Sphaeralcea/TTL_Calculator_4_Banger/2816Pgm.jpg

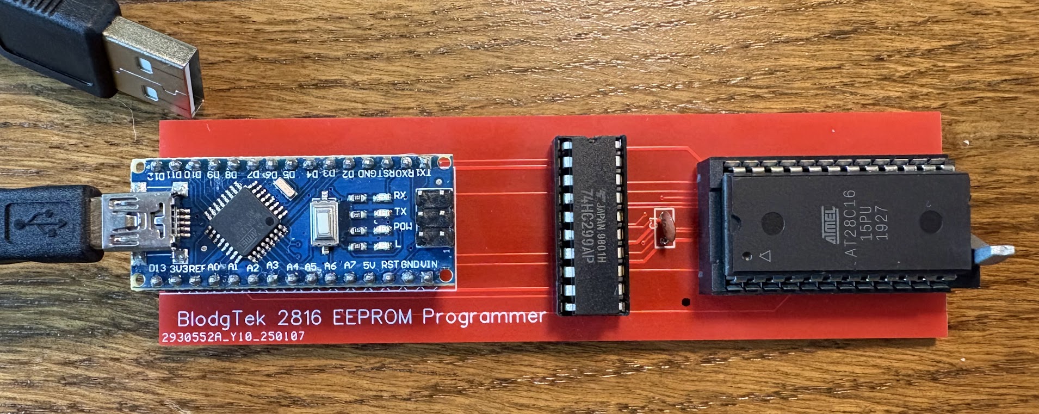
2816Pgm.jpg
