Sphaeralcea/TTL_Calculator_4_Banger/PCB_PIC.jpg

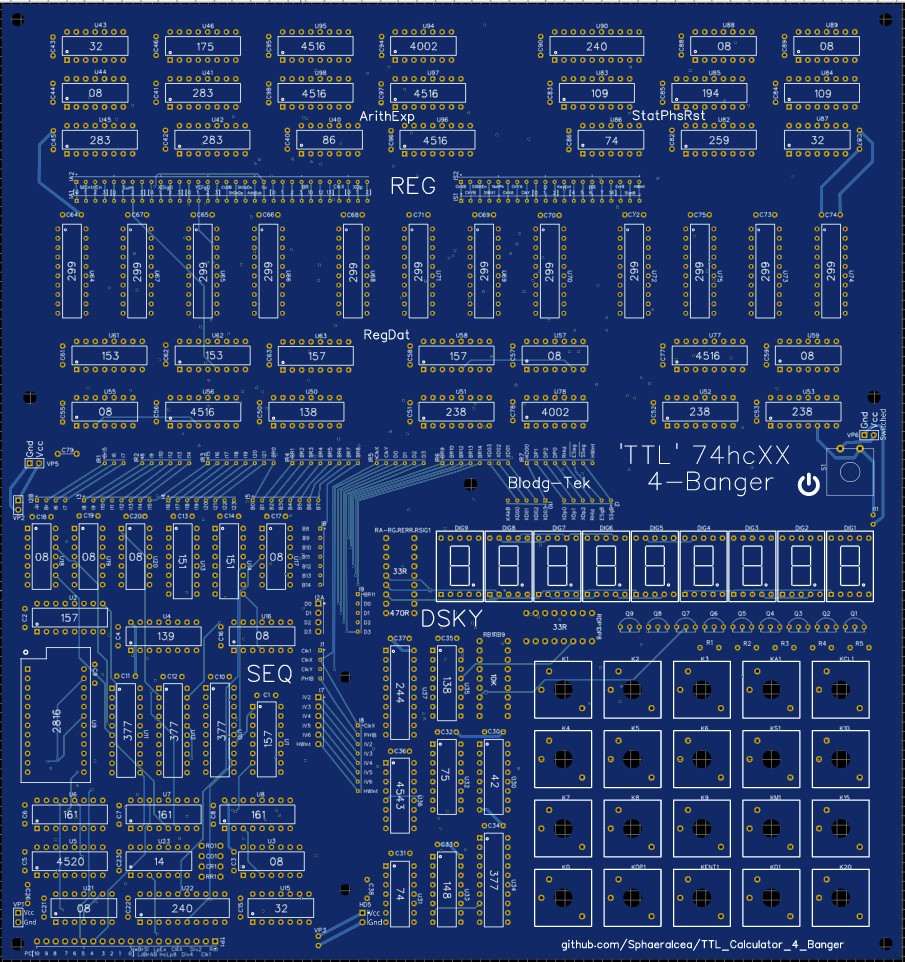
PCB_PIC.jpg
