Sphaeralcea/TTL_Calculator_4_Banger/README.md

# TTL_Calculator_4_Banger
A 4-function, 8-digit, floating point calculator implemented in 74hcXX chips
<pre>
Contents
     Calc4Banger_Overview.pdf - Architecture and design documentation
     BCD_Arithmetic.pdf - Review of BCD addition and subtraction
    *SEQ.pdf - Sequencer unit schematic diagram
    *DSKY.pdf - Display and Keyboard unit schematic diagram
    *REG*.pdf - Register and Arithmatic unit schematic diagram
    uCode7.5.3.2.xlsx - Microcode source
    MathSim2.xlsx - Spreadsheet simulator for math uCode algorithms
    *.h - Microcode object (Arduino C code array)
    *.ini - Arduino based microcode programmer (Arduino C code)
    EEPROM*.pdf - 2816 programmer schematic diagram
    2816Pgm.jpg - Picure of 2816 programmer
    PCB_PIC.jpg - Graphic of the PCB
    4-Banger-Pic.jpg - Picture of the completed project
    CalcRev5.7.3.zip - Zipped Logisim-evolution RTL model
</pre>
