Sphaeralcea/TTL_Calculator_4_Banger/Calc4Banger_Overview.pdf

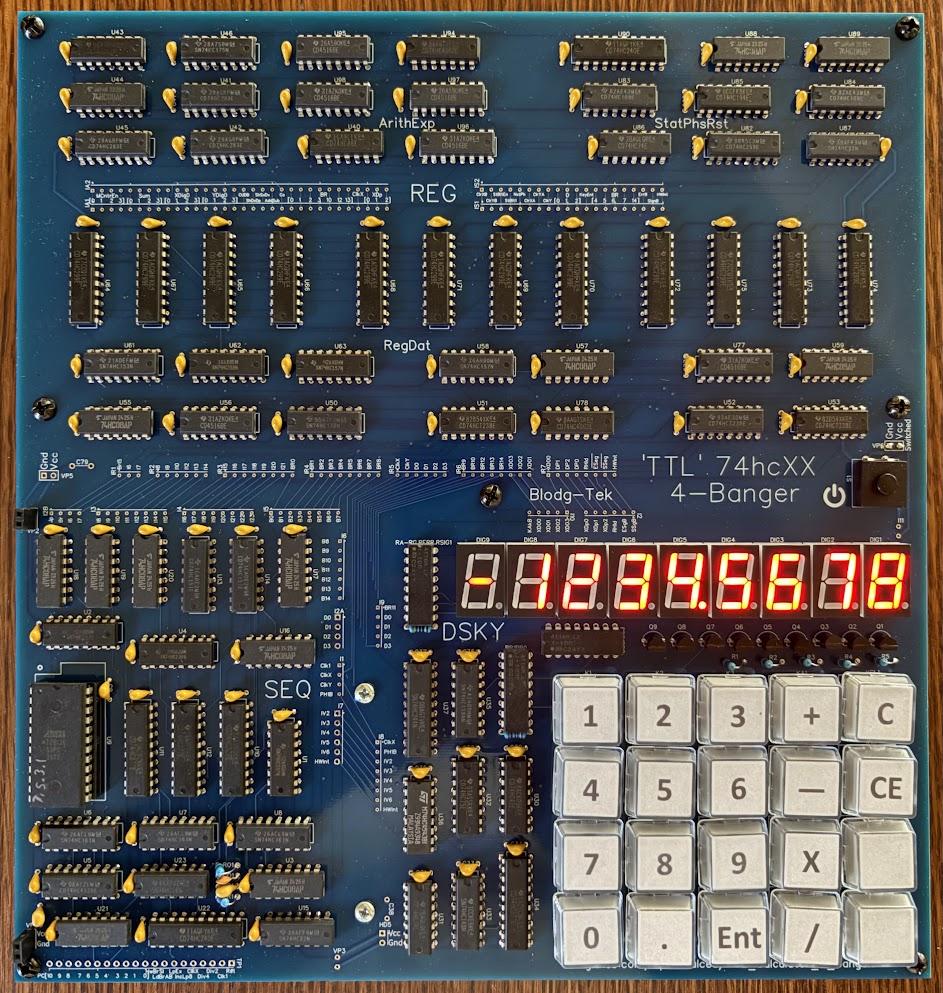
[picture p3: figure]

## https://github.com/Sphaeralcea/TTL_Calculator_4_Banger

# Specs

# - 9x10” PCB, 4 layers - All 74hcXX logic implementation (plus 3 4XXX) chips, 76 total, and one 2816 EEPROM - Purpose built architecture (not a CPU architecture) - RPN style operation (HP Enter key)

- Add, subtract, multiply, and divide, clear entry,

# clear all - 8 numeric digits plus an Error and sign digit - Max num: +99,999,999 to -99,999,999 - Min Num: +0.0000001 to -0.0000001 - Floating decimal point

- Signals error on overflow for all operations,

# divide by 0, and keyboard input overflow - Leading zero blanking during operand entry - Running total operation (last result = Operand1 + Enter) - No rounding logic or guard digits

# A “TTL” 4-Function Calculator Overview

## https://www.youtube.com/watch?v=umok5LHqRb0

# Top Level

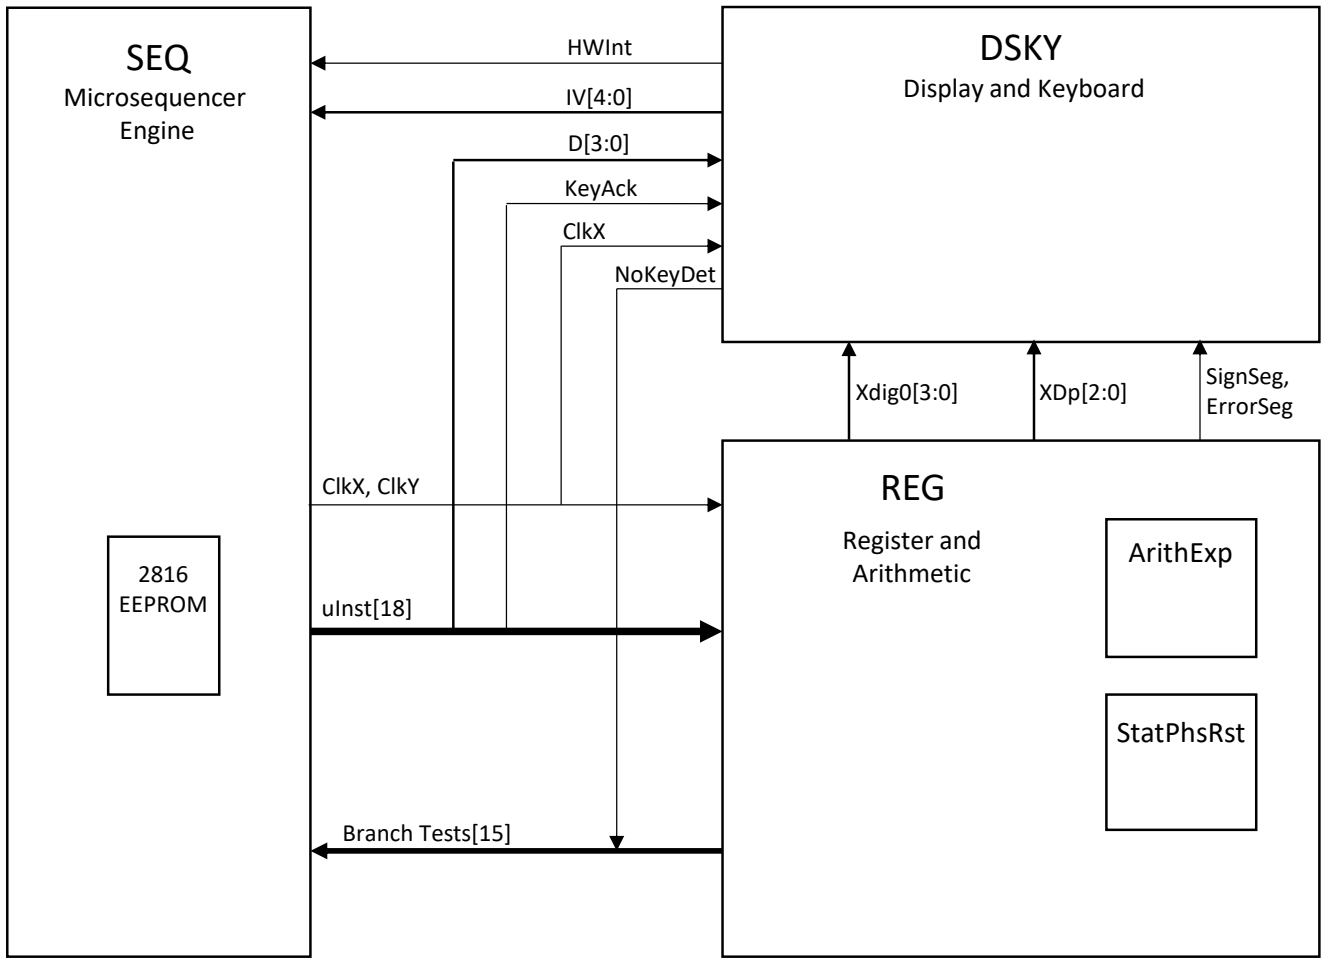
[picture p4: figure]
SEQ; DSKY; REG; ArithExp; StatPhsRst; HWInt; KeyAck; Branch Tests[15]; uInst[18]; ClkX, ClkY; ClkX; NoKeyDet; 2816 EEPROM; Microsequencer Engine; Display and Keyboard; Register and Arithmetic; Xdig0[3:0]; XDp[2:0]; SignSeg,; ErrorSeg

# Overview

# 3 Major logic blocks

# - SEQ: Micro-sequencer engine with 2Kx8b uROM - 24-bit micro-instruction word - Unconditional branch, 16 conditional branches, 1 NMI-type interrupt - Single level loop counter (no nesting) - Clock and reset generation - DSKY: Keyboard and Display unit

- 9-digit LED display sequencing,

# - 18(20)-key keyboard encoding (2 keys not used) - REG: Register-Arithmetic unit - 3, 8-digit registers (4-bits X 8) - 1 digit BCD adder/subtractor and exponent calculator (counters)

- 7 status and control register bits,

# operation progress tracking state machine

# - Architectural deficits (intentional) - No rounding logic, guard digits - Architectural bugs (unintentional) - Accuracy loss dividing 2 8-digit integers

# Top Level Process View

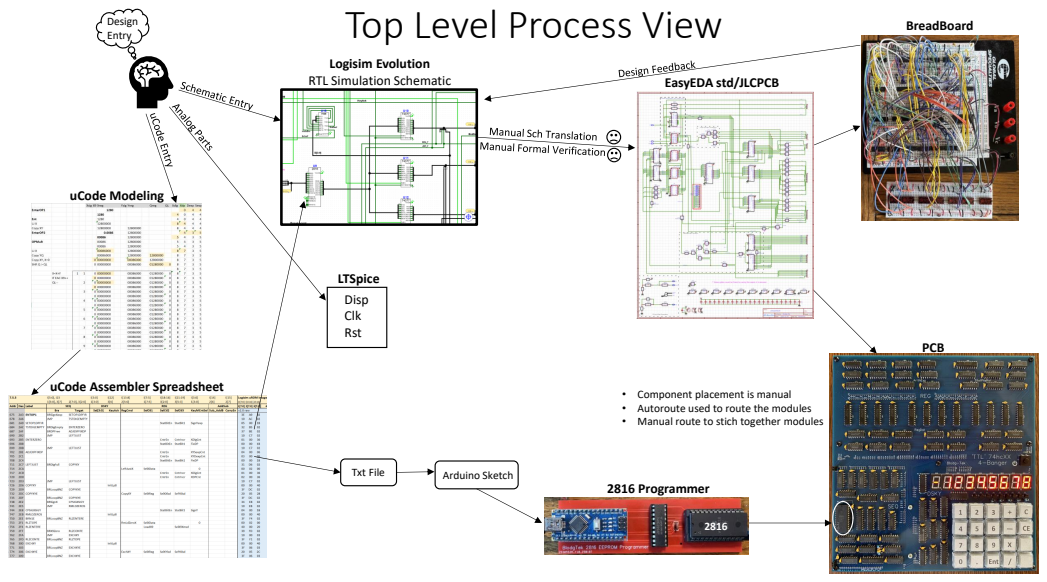
[picture p5: page 4]
Txt File; Arduino Sketch; Design Entry; BreadBoard; Logisim Evolution; RTL Simulation Schematic; EasyEDA std/JLCPCB; PCB; 2816 Programmer; uCode Modeling; Disp Clk Rst; LTSpice

uCode Assembler Spreadsheet

• Component placement is manual
• Autoroute used to route the modules
• Manual route to stich together modules

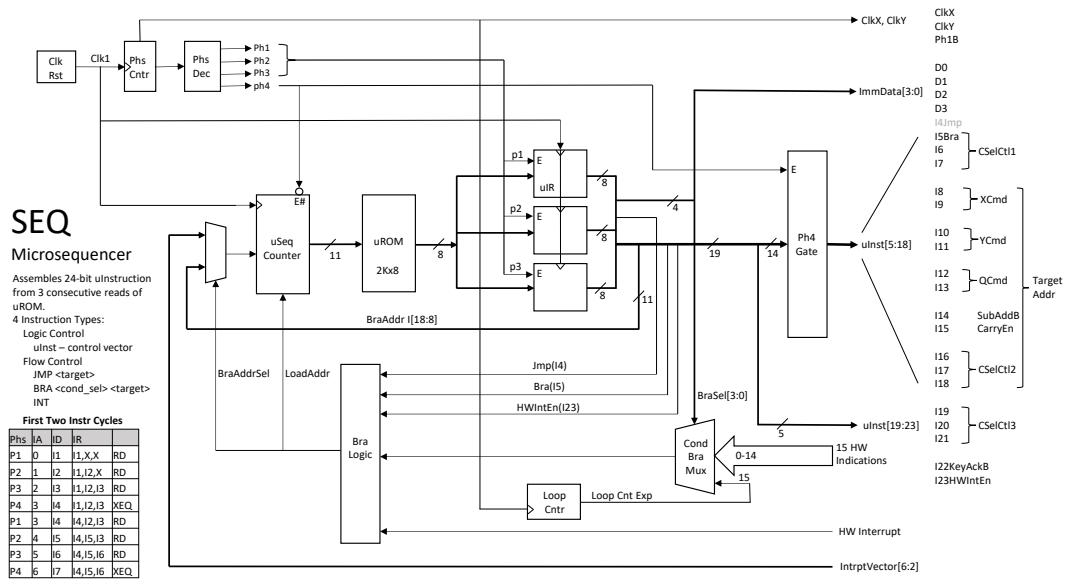
[picture p6: page 5]

Phs | IA | ID | IR
P1 | 0 | I1 | I1,X,X | RD
P2 | 1 | I2 | I1,I2,X | RD
P3 | 2 | I3 | I1,I2,I3 | RD
P4 | 3 | I4 | I1,I2,I3 | XEQ
P1 | 3 | I4 | I4,I2,I3 | RD
P2 | 4 | I5 | I4,I5,I3 | RD
P3 | 5 | I6 | I4,I5,I6 | RD
P4 | 6 | I7 | I4,I5,I6 | XEQ

# Power-On Reset Startup

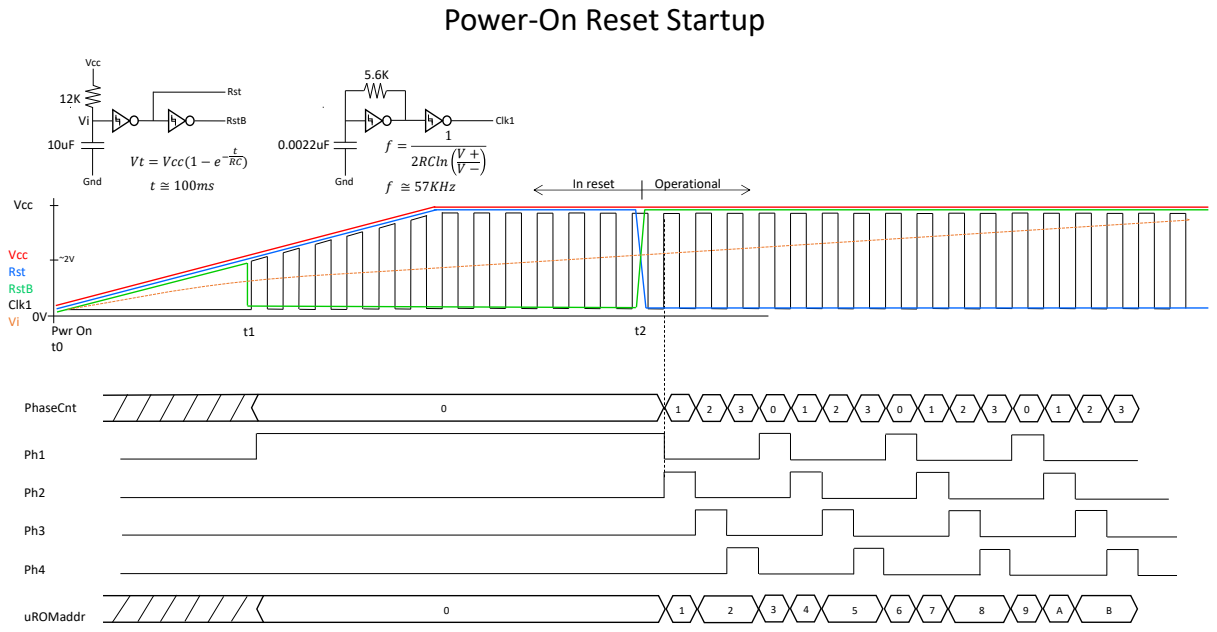
[picture p7: page 6]
PhaseCnt; uROMaddr; Vcc Rst RstB Clk1 Vi; Vcc; In reset; Operational; Pwr On; Gnd; Rst; RstB; Vt = Vcc(1− e; 1 2RCln V + V −; Clk1; f ≅ 57KHz

# Sequencer (SEQ)

# - Includes Clock, Reset and Timing generation

# - Schmitt trigger reset holds sequencer in reset until power rises to ~75% VCC - Schmitt trigger oscillator generates 1X clock - 1X clock drives SEQ logic only. Does not clock other units

- 1X clock feeds the uInst PC, the IR, and the phase counter which also generates the div4

# clocks, ClkX and ClkY - ClkX and ClkY clock the other units

# - Sequencer operates on a 4-phase instruction cycle to construct and present a 24-bit micro-instruction, 23 of which are available to control external hardware

- First 3 phases read three consecutive bytes from uROM and stores them in 3 8-bit registers

# - During first 3 phases, external hardware sees 0’s (inactive) on all signals - Fourth phase ungates the uInstruction and presents it to external hardware - D0 – D3: Immediate data and select field - I4: Instruction type. This bit is reserved for the sequencer’s exclusive use

# - I4=0: Instruction is a hardware control instruction - I4=1: Instruction is a flow control instruction (JMP or BRA)

# Sequencer (SEQ)

# - I5: HW control and flow control qualifier

# - If I4=0, then I5 is just another hardware control bit - If I4=1, then I5 is flow control qualifier

## - I5=0, unconditional (JMP) - I5=1, conditional (BRA)

- One of 16 conditions is tested, selected by D[3:0]. If condition is true then branch is taken

## - D[3:0]=0xF is reserved. Dedicated internally to implement a simple for-loop capability

# - I6 – I21: uINSTR bits

- I22: Loop Init: Used internal to SEQ to reset a counter that implements a simple for-loop

# capability

# - I22 is also used as external to SEQ to register the state of keyboard (KeyAckB)

- I23: Interrupt enable. Used internal to SEQ to enable a hardware-initiated branch. Taken

# if external hardware has asserted the HWInt signal

# - External hardware provides the target address through a 5-bit vector, IV[6:2] - The target address is formed by appending IV[6:2] with b00

- Hardware jump targets are confined to uROM addresses at 4-byte boundaries between 0x10 to 0x7C

# - I23 is available external to SEQ but not used

# Sequencer (SEQ)

# - A primitive looping structure provides the ability to create loops up to 9 iterations (0-8)

# - Loop counter reset by asserting I22 (InitLP8) - Loop count tested and incremented by a conditional jump with D[3:0]=0xF (BRLoop8NZ) - Loop count expires when loop count reaches 8, and loop will fall through on the next loop count test (BRLoop8NZ)

- Note: There is no subroutine call and return capability provided.

# - Since all keyboard service routines return to the keyboard-display loop, an unconditional JMP to this loop serves as an adequate return from keyboard service

routines.

# Sequencer Instruction Timing

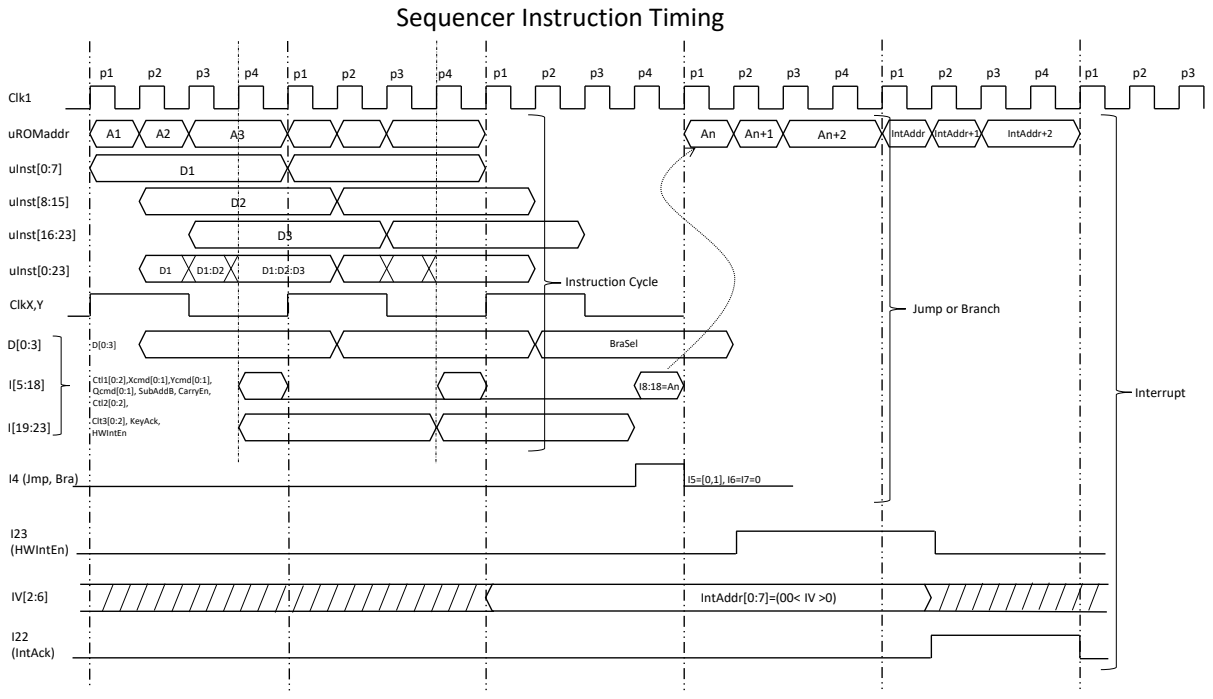
[picture p8: page 10]
uROMaddr; uInst[0:7]; uInst[8:15]; uInst[16:23]; uInst[0:23]; Clt3[0:2], KeyAck, HWIntEn; Ctl1[0:2],Xcmd[0:1],Ycmd[0:1], Qcmd[0:1], SubAddB, CarryEn, Ctl2[0:2],; ClkX,Y; Clk1; I4 (Jmp, Bra); I23 (HWIntEn); IntAddr; IntAddr[0:7]=(00< IV >0); IntAddr+1; IntAddr+2; I22 (IntAck); Interrupt; Instruction Cycle; BraSel

Jump or Branch

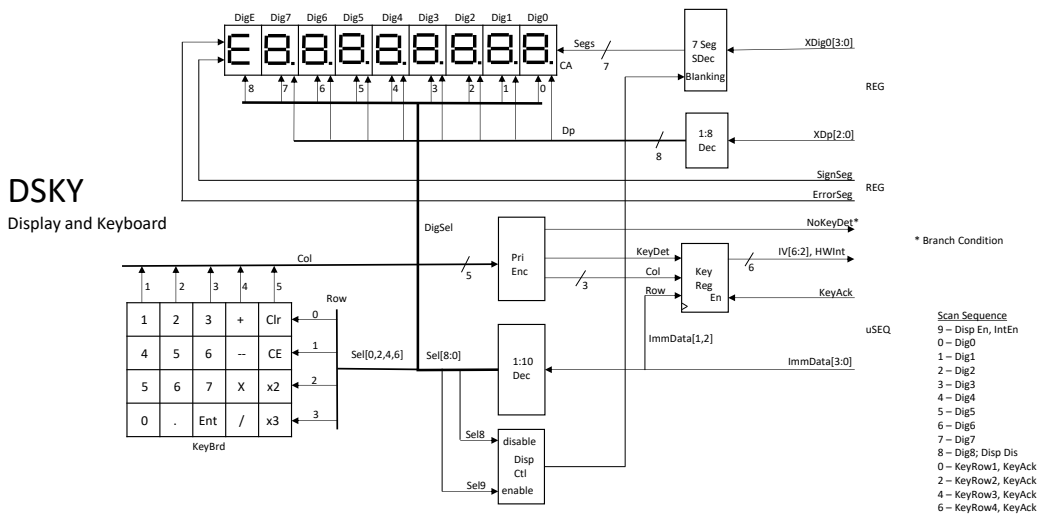
[picture p9: page 11]
Sel[8:0]; Dec; Pri Enc; ImmData[3:0]; ImmData[1,2]; IV[6:2], HWInt; 7 Seg SDec; XDig0[3:0]; SignSeg; ErrorSeg; XDp[2:0]; KeyAck; DSKY; uSEQ; REG; KeyDet; Col; Row; Key Reg En; DigE; Dig7; Dig6; Dig5; Dig4; Dig3; Dig2; Dig1; Dig0; Segs; DigSel; Scan Sequence 9 – Disp En, IntEn 0 – Dig0 1 – Dig1 2 – Dig2 3 – Dig3 4 – Dig4 5 – Dig5 6 – Dig6 7 – Dig7 8 – Dig8; Disp Dis 0 – KeyRow1, KeyAck 2 – KeyRow2, KeyAck 4 – KeyRow3, KeyAck 6 – KeyRow4, KeyAck; Sel[0,2,4,6]; Sel9; Sel8; BIanking; KeyBrd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

Display and Keyboard

1 | 2 | 3 | + | Clr

0 | . | Ent | / | x3

# Display and Keyboard (DSKY)

# - DSKY is a passive module with no autonomy. Completely controlled by SEQ - Display and keyboard scan is performed via D[3:0] from SEQ

# - The display is enabled by D[3:0]=b1001, and it is disabled by b1000 - Dig0 is activated by D[3:0]=b0000, Dig7 by b0111, the Sign/Error digit by b1000

- Row 0 of the keyboard matrix is activated by b0000, row 1 by b0010, row 2 by 0100, and row 3 by

# b0110. The display is disabled during row scan

- REG provides BCD data for each digit to display, 3-bit decimal point position, and the sign and

# error segments - When a key is pressed in an activated row, a key detect signal is raised

- If microcode running on SEQ tests the detect signal to be true, then it may assert the KeyAck (I22) signal back to DSKY which registers the row and column where the depressed key resides and

# asserts the HWInt signal

- On any microcode instruction that asserts HWIntEn (I23) while HWInt is asserted, SEQ flow will

# jump to the uROM address formed by the concatenation of col[2:0], row[1:0], and b’00

# DSKY LOOP

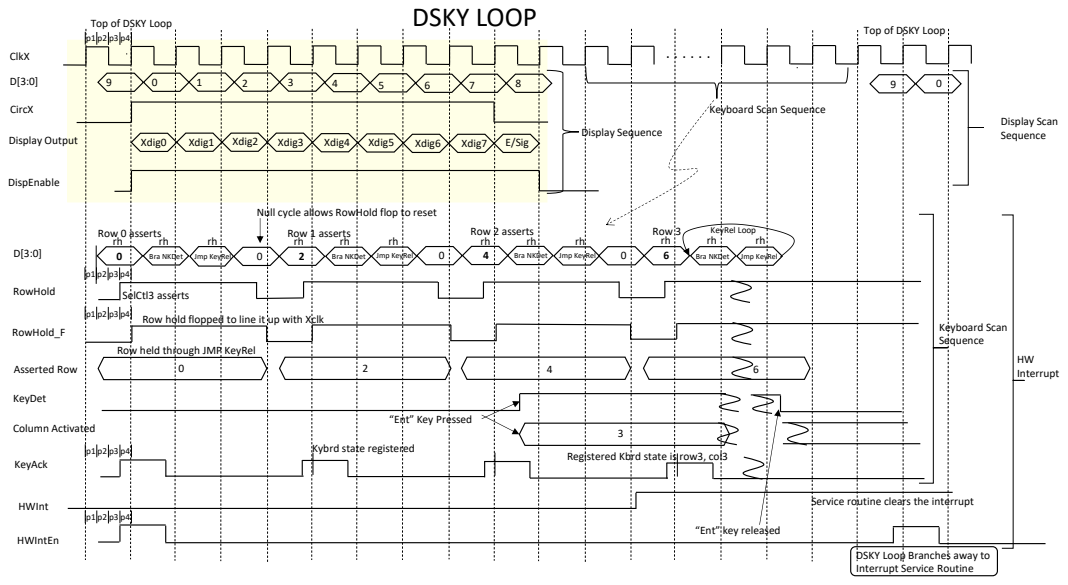
[picture p10: page 13]
CircX; ClkX; Display Output; DispEnable; Xdig0; Xdig1; Xdig2; Xdig3; Xdig4; Xdig5; Xdig6; Xdig7; E/Sig; Top of DSKY Loop; Display Sequence; Display Scan Sequence; RowHold; Asserted Row; KeyDet; Column Activated; KeyAck; Jmp KeyRel; KeyRel Loop; Row 0 asserts; RowHold_F; SelCtl3 asserts; Bra NKDet; Row 1 asserts; Row 2 asserts; Row 3; Keyboard Scan Sequence; HWIntEn; HWInt; HW Interrupt

Keyboard Scan Sequence

Null cycle allows RowHold flop to reset

Row hold flopped to line it up with Xclk

Row held through JMP KeyRel

“Ent” Key Pressed

Kybrd state registered

Registered Kbrd state is row3, col3

Service routine clears the interrupt

“Ent” key released

DSKY Loop Branches away to
Interrupt Service Routine

# REG

## Register and Math

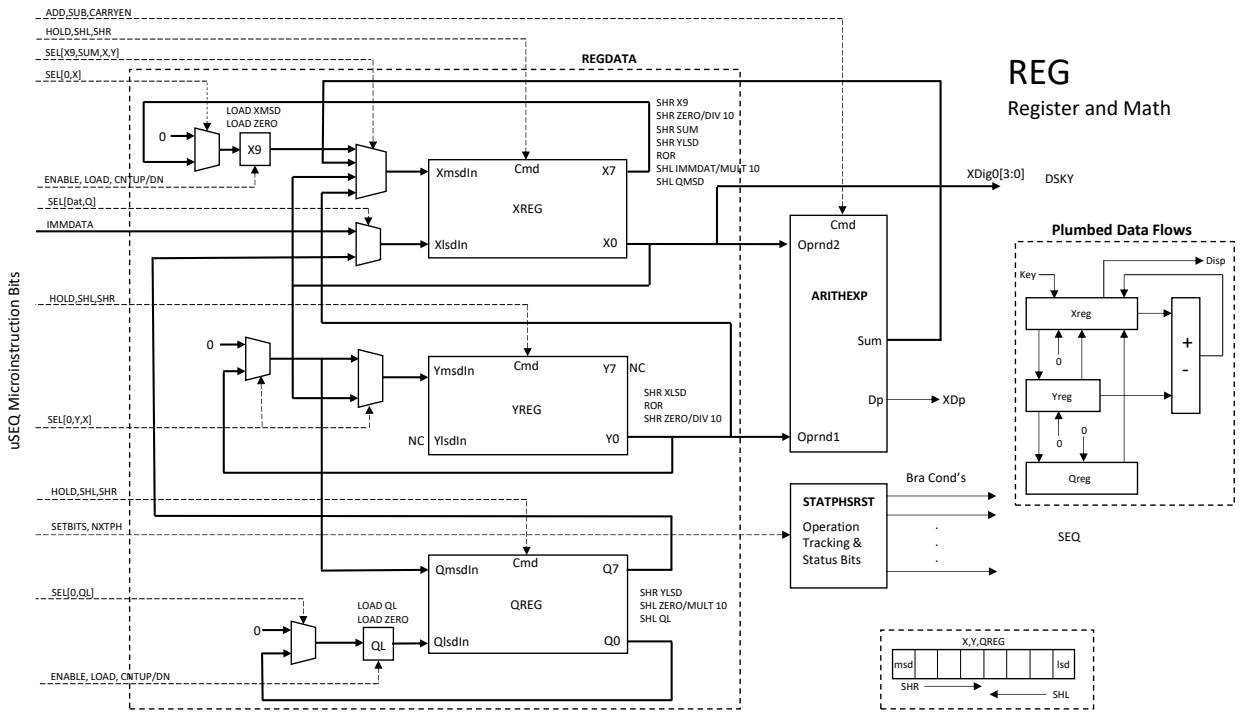
[picture p11: page 14]
XREG; YREG; QREG; XlsdIn; XmsdIn; QlsdIn; QmsdIn; YmsdIn; YlsdIn; Cmd; HOLD,SHL,SHR; ARITHEXP; Oprnd1; Oprnd2; Sum; IMMDATA; msd; lsd; SHR; SHL; X,Y,QREG; DSKY; SEL[Dat,Q; SEL[0,X]; SEL[0,Y,X]; SEL[0,QL]; Operation Tracking & Status Bits; SETBITS, NXTPH; XDig0[3:0]; SEQ; STATPHSRST; Bra Cond’s; LOAD QL LOAD ZERO; LOAD XMSD LOAD ZERO; XDp; REGDATA; Xreg; Yreg; Qreg; Key; Disp

ADD,SUB,CARRYEN
HOLD,SHL,SHR
SEL[X9,SUM,X,Y]

SHR X9
SHR ZERO/DIV 10
SHR SUM
SHR YLSD
ROR
SHL IMMDAT/MULT 10
SHL QMSD

ENABLE, LOAD, CNTUP/DN

Plumbed Data Flows

uSEQ Microinstruction Bits

SHR XLSD

SHL ZERO/MULT 10
SHL QL

# REG: Registers, Data Steering and Compute

# - REG is a passive unit with no autonomy. Completely controlled by SEQ - Three Registers; XReg, YReg and QReg are each arrays of 8 BCD (4-bit) digits

- Each register supports shift operations; either SHR, SHL, or both. SHR moves digits one position from MSD (most significant digit) to LSD, and the current LSD exiting the register with SRC replacing the MSD. SHL moves digits from

## LSD to MSD and the MSD exiting the register with SRC replacing the LSD

## - SHRX SRC: X9, SUM, XLSD, YLSD - SHLX SRC: IMMData, QMSD - SHRY SRC: Zero, YLSD, XLSD - SHRQ SRC: Zero, YLSD - SHLQ SRC: Zero, QLSD

- Each register may operate individually or in tandem with others but only limited cases of simultaneous register shifting are supported. Examples include: Exchange the values of Xreg and Yreg; Adding Xreg and Yreg, with SUM replacing Xreg while Yreg circulates (or replaced with zero); Copy Xreg to Yreg while Xreg circulates (or replaced with

## zero)

- X9 and QL are single BCD digit registers (loadable counters), auxiliary to Xreg and Qreg, respectively.
- X9 accumulates carries out of Xmsd for Addition and Multiplication operations and is used to test Xreg digits for 0
- QL is used for Multiplication as a loop counter and for Division as partial quotient accumulator

## - Each can increment or decrement by one and each is loadable from two sources:

## - X9 SRC: Zero, XMSD - QL SRC: Zero, QLSD

# ArithExp – BCD Adder Subtractor

- ArithExp is a single digit BCD adder/subtractor that operates only on XLSD and YLSD. The

# output of Arith is the SUM routed only to XMSD

- Additional outputs indicate if the add generated a carry out and if the result of a subtraction is a negative number.
- Subtraction is done through 10s complement arithmetic.

# - The Add/Sub block is implemented with a cascade of three combinational logic stages:

# - 10’s complement of one input (subtraction) - Summing the inputs - BCD correction of result

# - The CarryO bit is valid for exactly one clock following the sum. This imposes a requirement for any operation on multi-digit numbers be carried out with contiguous add instructions (no intervening cycles)

- The IsNeg bit is valid for exactly one clock following the sum. This requires that action to be taken as a result of the IsNeg signal is immediate.
- If the result of a subtraction is negative, the 10’s complement result is stored in Xreg and

# additional uCode performs subtraction of the result from 0, returning the desired result

# ArithExp – Metadata Counters

# - ArithExp includes 4 counters that react to key strokes to compute sum of exponents, difference of exponents, digit count, and decimal point position

# - Incremented or decremented by microcode instructions

- XDigCnt – increments for each numeric key. If zero(s) is the first keystroke, it is not counted
- XDpCnt – increments for each numeric key after the decimal point (counts digits in fractional portion of

# operand)

- SexpCnt, DexpCnt – hold the sum and difference, respectively, of the exponents of the two operands
- Positive Exponent - first key of operand is numeric. Increment for each numeric key until decimal point is keyed
- Negative Exponent - first key of operand is decimal point key. Decrement for each leading zero keyed until non

## zero numeric key - SexpCnt - for each operand, positive exponents increment up, negative exponents decrement down - DexpCnt - for first operand, positive exponents increment up, negative exponents decrement down - For second operand, negative exponents increment up, positive exponents decrement down

# - Via microcode instructions, DexpCnt can be transferred to SexpCnt. SexpCnt can be transferred to XDpCnt. DexpCnt can be transferred to XDpCnt in two steps

# StatPhsRst

# - There are two reset domains for sequential logic in REG, X and Y

# - The Xreg domain includes Xreg and state associated with Xreg

- X reset is triggered by a microcode instruction and by the transition from entering the first

# operand to entering the second operand

# - The Yreg domain includes Yreg and Qreg and associated state

# - Y reset is triggered by a microcode instruction

- The Rst part of StatPhsRst is a reset synchronizer to filter spurious logic glitches from

# SEQ on X and Y domain resets - It also includes single pulse generator that generates an alternate X domain reset when the first key of the second operand is detected

# - The Stat part of StatPhsRst is an array of status bits to store sign bits for operands and exponents and other state information needed to parse keystrokes. Bits are set and cleared by microcode instructions and by reset events

# StatPhsRst

# - The Phs part of StatPhsRst is a state machine that tracks the phase of the operation underway. Its state variables are tested by branch instructions - States include

- Idle* – System has cycle through reset but no keys have been pressed (virtual state) - Op1Ph* – First operand is being entered (virtual state) - EOp1Ph – First operand is entered but second operand has not started - Op2Ph – Second operand is being entered - OprPh – One of the 4 operations is underway

* Idle state and Op1Ph state do not need actual state variables but they represent operational

# states of the overall machine

# - The state machine is advanced by a microcode instruction

- The transition from EndOp1 to Op2Ph will also happen with the first key starting operand2

## Status Bits

StatPhsRst | Rst

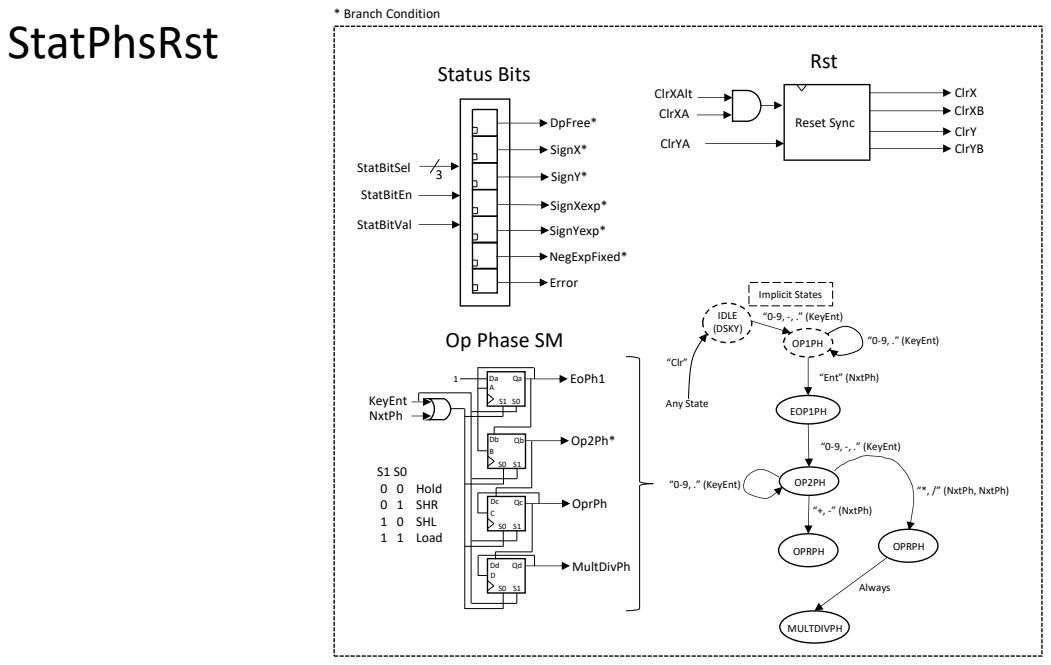
[picture p12: page 20]
NegExpFixed*; Error; SignYexp*; SignXexp*; SignY*; DpFree*; SignX*; StatBitEn; StatBitVal; Reset Sync; ClrXA; ClrYA; ClrX ClrXB; ClrY ClrYB; EOP1PH; OPRPH; MULTDIVPH; “Ent” (NxtPh); “0-9, -, .” (KeyEnt); “+, -” (NxtPh); “*, /” (NxtPh, NxtPh); “0-9, .” (KeyEnt); “Clr”; Any State; Implicit States; IDLE (DSKY); Always; StatBitSel; * Branch Condition; S1 S0 0 0 Hold 0 1 SHR 1 0 SHL 1 1 Load; NxtPh; KeyEnt; MultDivPh; OprPh; EoPh1; ClrXAlt

Op Phase SM

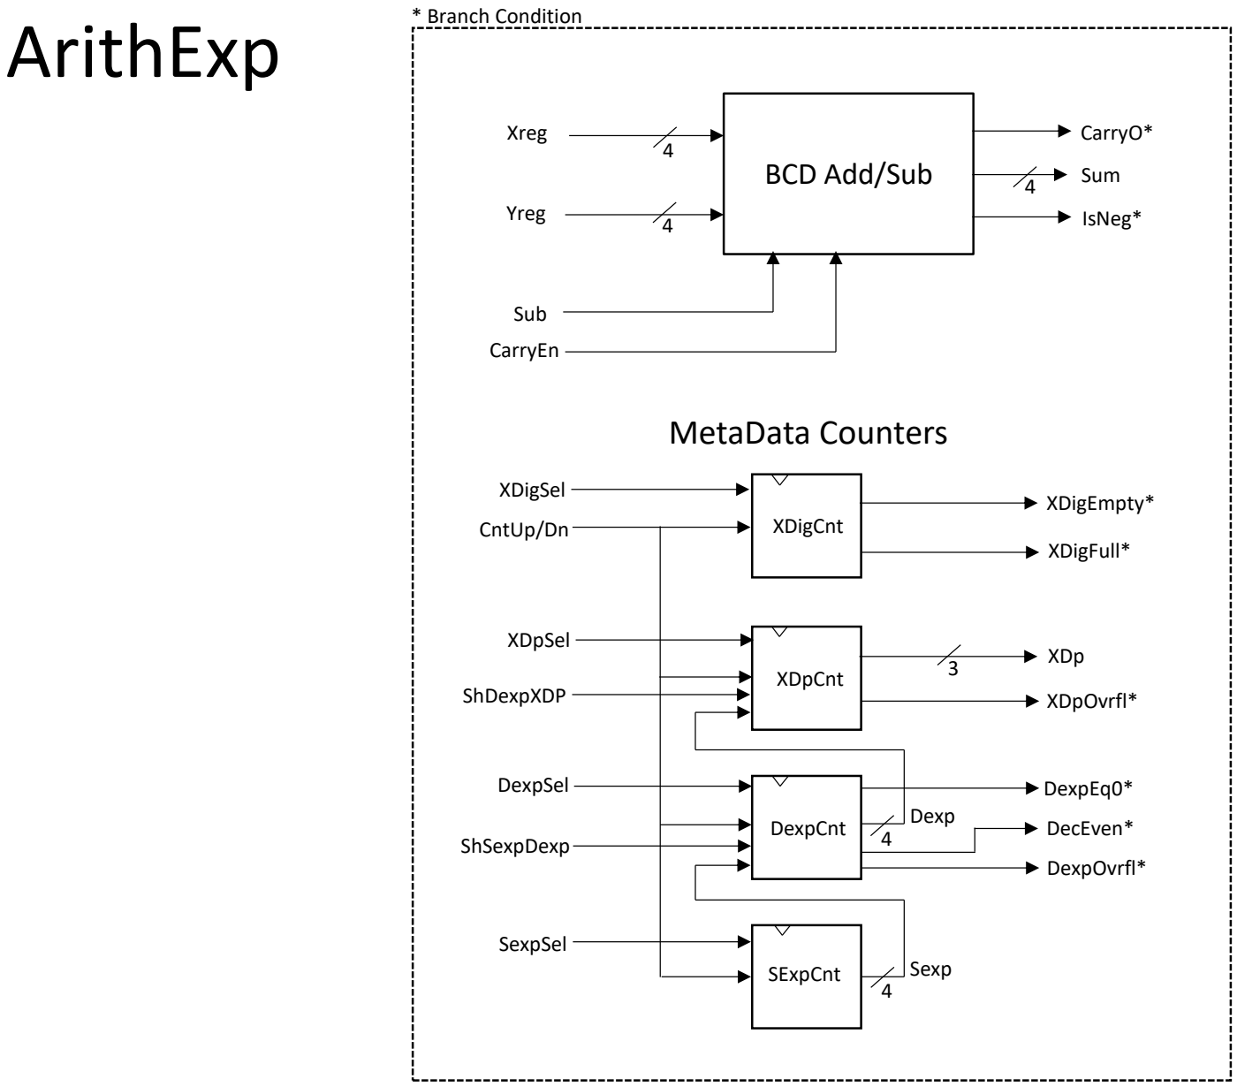
[picture p13: figure]
ArithExp; * Branch Condition; XDigCnt; XDpCnt; DexpCnt; SExpCnt; Yreg; Xreg; Sub; CarryEn; Sum; CarryO*; IsNeg* 4; CntUp/Dn; XDigSel; XDpSel; DexpSel; SexpSel; XDigFull*; XDpOvrfl*; XDp 3; DexpOvrfl*; Sexp; Dexp; DexpEq0*; MetaData Counters; BCD Add/Sub; XDigEmpty*; DecEven*; ShSexpDexp; ShDexpXDP

## Idle

## Operand

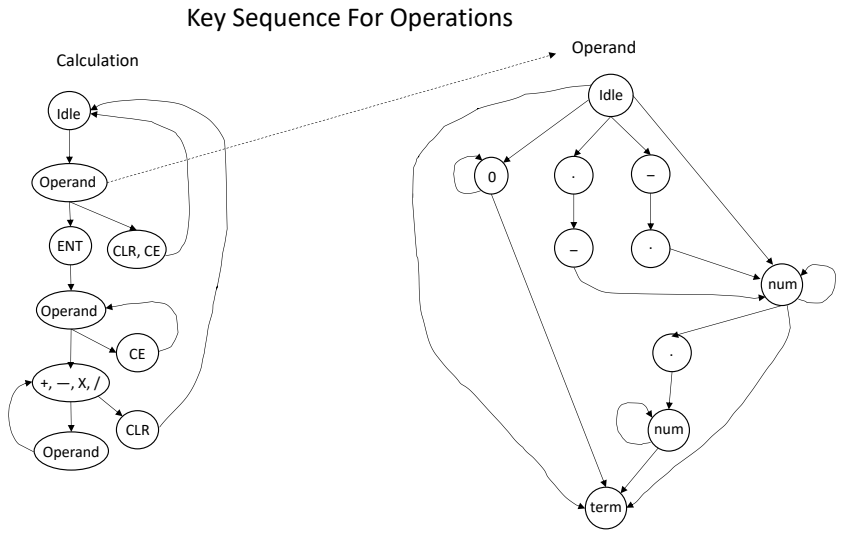
[picture p14: page 22]
num; term; Operand; ENT; CLR; CLR, CE; Idle; Calculation

Key Sequence For Operations

# How Operands Are Entered

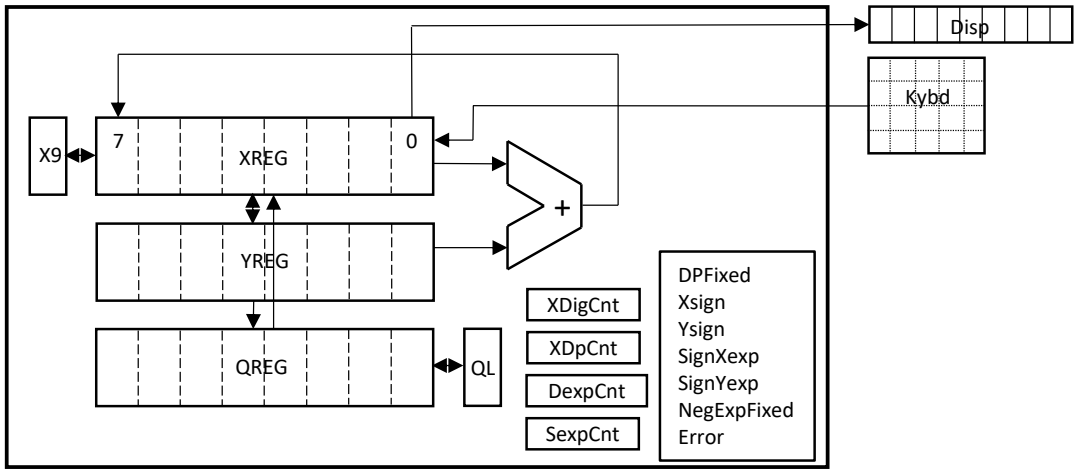
[picture p15: figure]
XREG; YREG; QREG; Kybd; XDigCnt; XDpCnt; DexpCnt; SexpCnt; Disp; DPFixed Xsign Ysign SignXexp SignYexp NegExpFixed Error

### XDigCnt – Counts numeric digits entered into Xreg XDpCnt – Counts digits after decimal point in Xreg DexpCnt – Computes difference between exponents in Xreg and Yreg SexpCnt – Computes sim of exponents in Xreg and Yreg NegExpFixed – Indicates that accounting for negative exponent is done

## REG Unit Data Model

| Yreg | Xreg/Disp
Key | 76543210 | 7 6 5 4 3 2 1 0 | Xdig XDp Sexp Dexp DpFix NEF | PhsSt
num | | 1 . | 1 | 0 | 1 | 1 | 0 | 0 | op1ph
num | | 1 2 . | 2 | 0 | 2 | 2 | 0 | 0 | op1ph
Dp | | 1 2 . | 2 | 0 | 2 | 2 | 1 | 0 | op1ph
num | | 1 2 . 3 | 3 | 1 | 2 | 2 | 1 | 0 | op1ph
num | | 1 2 . 3 4 | 4 | 2 | 2 | 2 | 1 | 0 | op1ph
Ent | 12340000 | 1 2 . 3 4 0 0 0 0 | 8 | 6 | 1 | 1 | 1 | 0 | eop1ph
num | 12340000 | 9 . | 1 | 0 | 2 | 0 | 0 | 0 | op2ph
num | 12340000 | 9 8 . | 2 | 0 | 3 | -1 | 0 | 0 | op2ph
num | 12340000 | 9 8 7 . | 3 | 0 | 4 | -2 | 0 | 0 | op2ph
Dp | 12340000 | 9 8 7 . | 3 | 0 | 4 | -2 | 1 | 0 | op2ph
num | 12340000 | 9 8 7 . 6 | 4 | 1 | 4 | -2 | 1 | 0 | op2ph
+ | 12340000 | 9 8 7 . 6 0 0 0 0 | 8 | 5 | 3 | -1 | 1 | 0 | oprph
Dp | | 0 . | 1 | 0 | 0 | 0 | 1 | 0 | op1ph
num | | 0 . 0 | 2 | 1 | -1 | -1 | 1 | 0 | op1ph
num | | 0 . 0 0 | 3 | 2 | -2 | -2 | 1 | 0 | op1ph
num | | 0 . 0 0 0 | 4 | 3 | -3 | -3 | 1 | 0 | op1ph
num | | 0 . 0 0 0 1 | 5 | 4 | -3 | -3 | 1 | 1 | op1ph
num | | 0 . 0 0 0 1 2 | 6 | 5 | -3 | -3 | 1 | 1 | op1ph
num | | 0 . 0 0 0 1 2 3 | 7 | 6 | -3 | -3 | 1 | 1 | op1ph
Ent | 12300000 | 0 . 0 0 0 1 2 3 0 | 8 | 7 | -4 | -4 | 1 | 1 | eop1ph
num | 12300000 | 9 . | 1 | 0 | -3 | -5 | 0 | 0 | op2ph
Dp | 12300000 | 9 . | 1 | 0 | -3 | -5 | 1 | 0 | op2ph
num | 12300000 | 9 . 8 | 2 | 1 | -3 | -5 | 1 | 0 | op2ph
num | 12300000 | 9 . 8 7 | 3 | 2 | -3 | -5 | 1 | 0 | op2ph
+ | 12300000 | 9 . 8 7 0 0 0 0 0 | 8 | 7 | -4 | -4 | 1 | 0 | oprph
-14 | 0010
-13 | 0011
-12 | 0100
-11 | 0101
-10 | 0110
-9 | 0111
-8 | 1000
-7 | 1001
-6 | 1010
-5 | 1011
-4 | 1100
-3 | 1101
-2 | 1110
-1 | 1111
0 | 0000
1 | 0001
2 | 0010
3 | 0011
4 | 0100
5 | 0101
6 | 0110
7 | 0111
8 | 1000
9 | 1001
10 | 1010
11 | 1011
12 | 1100
13 | 1101
14 | 1110

Dec Bin

# MicroCode Sample

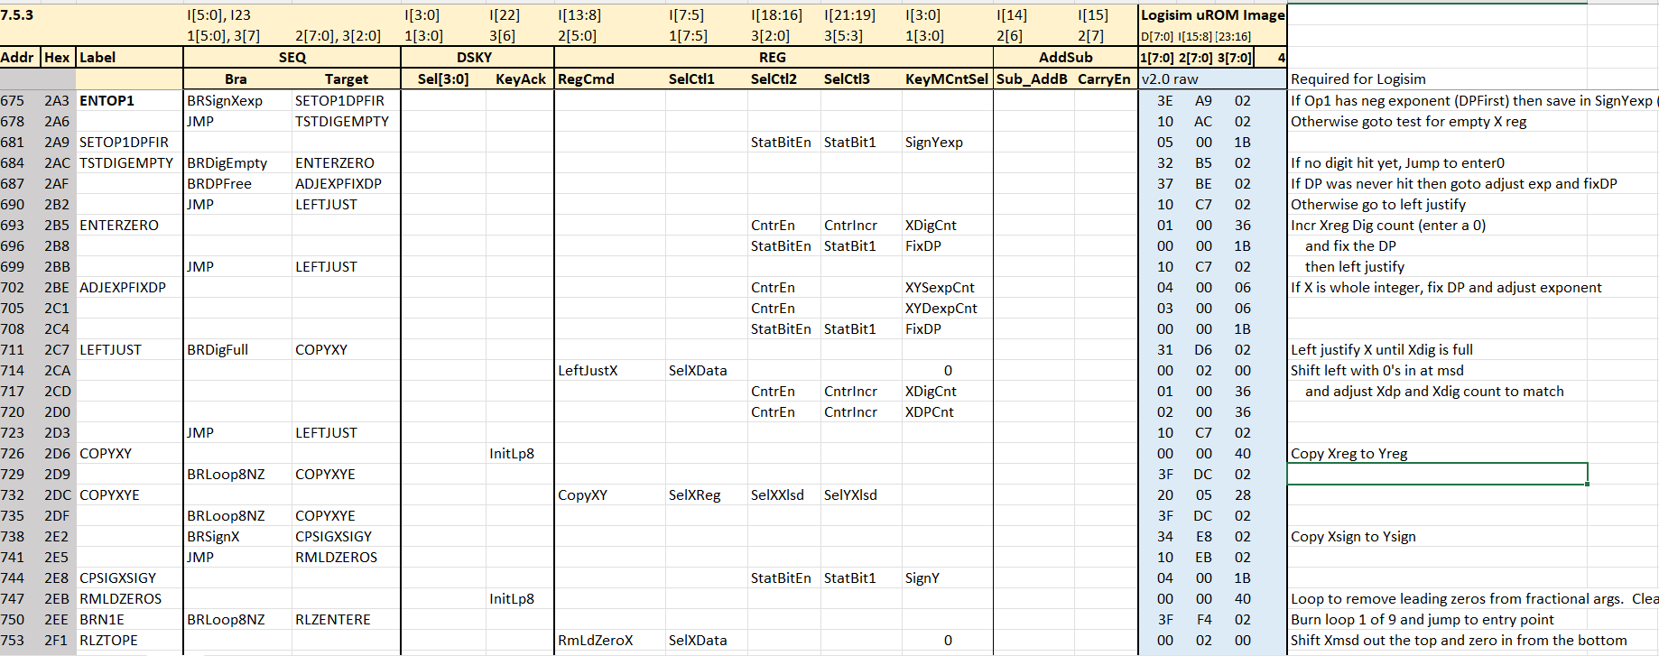
[picture p16: page 24]

# MicroCode Fields, Mnemonics and Codes

| Jmp/Bra | 1[4] | 1[3:0] | RegCmd | 2[5:0] | SelCtl1 | 1[7:5] | SelCtl2 | 3[2:0] | CtlSel3 | 3[5:3] | KeyMCntSel | 1[3:0]
| JMP | 1 | 0000 | CircX | 000001 | SelXReg | 001 | ClrXPh1 | 001 | SelQLQlsd | 001 | 0 | 0000
BR0 | BRDecEven | 1 | 0000 | DPAdjX | 000001 | LoadX9 | 010 | ClrYPh2 | 010 | SelYQYlsd | 010 | 1 | 0001
BR1 | BRDigFull | 1 | 0001 | EntNumX | 000010 | SelXQmsd | 011 | StatBitEn | 011 | StatBit1 | 011 | 2 | 0010
BR2 | BRDigEmpty | 1 | 0010 | LeftJustX | 000010 | LoadQL | 100 | SelXYlsd | 100 | SelX9Xmsd | 100 | 3 | 0011
BR3 | BRDintOvrfl | 1 | 0011 | DPAdjY | 000100 | SHDexpXDP | 101 | SelXSum | 100 | SelYXlsd | 101 | 4 | 0100
BR4 | BRSignX | 1 | 0100 | CopyXY | 000101 | Reserved1 | 110 | NxtPh | 101 | CntrIncr | 110 | 5 | 0101
BR5 | BRSignY | 1 | 0101 | ExchXY | 000101 | Reserved2 | 111 | CntrEn | 110 | RowHold | 111 | 6 | 0110
BR6 | BRInOp2Ph | 1 | 0110 | AddSub | 000101 | HWINTEN | 000 | SHSexpDexp | 111 | SelYZero | 000 | 7 | 0111
BR7 | BRDPFree | 1 | 0111 | DivXY10 | 000101 | SelXData | 000 | SelXX9 | 000 | SelQZero | 000 | 8 | 1000
BR8 | BRQLZero | 1 | 1000 | ShrX9X8QDiv10 | 010001 | SelXSumX9 | 000 | SelXXlsd | 000 | SelX9Zero | 000 | 9 | 1001
BR9 | BRX9Zero | 1 | 1001 | CopyYQ | 010100 | ExtraSelCtl1 | 000 | ExtraSelCtl1 | 000 | SelQLZero | 000 | BlankNum | 1111
BR10 | BRDpOvrfl | 1 | 1010 | CopyQX | 100010 | ExtraSelCtl2 | 000 | ExtraSelCtl2 | 000 | ExtraSelCtl3 | 000 | XDigCnt | 0001
BR11 | BRNoKeyDet | 1 | 1011 | ApendDivdn | 000010 | ExtraSelCtl3 | 000 | | | | | XDPCnt | 0010
BR12 | BRIsNeg | 1 | 1100 | RmLdZeroX | 000010 | ExtraSelCtl4 | 000 | ALUCmd | 2[7:6] | SEQ/DSKY | 3[7:6] | XYDexpCnt | 0011
BR13 | BRCarryO | 1 | 1101 | CopyQ0QL | 100000 | | | SubXY | x1 | HWINTEN | 10 | XYSexpCnt | 0100
BR14 | BRSignXexp | 1 | 1110 | ShrX | 000001 | BR* | 001 | CarryEn | 1x | KeyAck | 01 | X9Cnt | 0101
BR15 | BRLoop8NZ | 1 | 1111 | ShlX | 000010 | | | | | InitLP8 | 01 | QLCnt | 0110
| BRSignYexp | 1 | 0110 | CopyYX | 000101 | | | | | | | FixDP | 0000
| BrNegExpTerm | 1 | 0101 | ExtraCmd3 | 000000 | | | | | | | SignXexp | 0001
ExtraBR2 | 0 | 0000 | ImmData asserts on Ph2 of each cycle | NegExpTerm | 0010
ExtraBR3 | 0 | 0000 | SelCtl1, SelCtl2, RegCmd, ALUCmd assert on Ph4 and is valid only Ph4 | SignX | 0011
HWINTEN | 0 | 0000 | SelCtl3, KeyAckB, HWIntEn Assert on Ph4 of each cycle | SignY | 0100
SelCtl3 Can assert simutaneous with JMP/BR*. SelCtl1/2 cannot. | SignYexp | 0101
| | | | | | | | | | | | AssertError | 0110

SelXReg | 001 | Select X reg MSD source from X reg or Y reg group
LoadX9 | 010 | Load X9 source into X9 reg
SelXQmsd | 011 | Select X reg source from Q Dig7
LoadQL | 100 | Load QL source into QL reg
SHDexpXDP | 101 | Load Dexp counter value into XDP counter
Reserved1 | 110 | Currently unassigned
Reserved2 | 111 | Currently unassigned
SelXData | 000 | Select X LSD reg source from D[3:0]
SelXSumX9 | 000 | Select X reg MSD source from Sum or X9 group
ClrXPh1 | 001 | Clear X reg domain devices
ClrYPh2 | 010 | Clear Y reg domain devices
StatBitEn | 011 | Enable status latches for write
SelXYlsd | 100 | Select X reg MSD source from Y reg LSD
SelXSum | 100 | Select X reg MSD source from SUM
NxtPh | 101 | Advance tracking state machine state
CntrEn | 110 | Enable selected counter for up/down advance
SHSexpDexp | 111 | Load Sexp counter value into Dexp
SelXX9 | 000 | Select X reg MSD source from X9 reg
SelXXlsd | 000 | Select X reg MSD source from X reg LSD
SelQLQlsd | 001 | Select QL reg source from Q reg LSD
SelYQYlsd | 010 | Select Y and Q reg MSD sources from Y reg LSD
StatBit1 | 011 | Set selected status bit to 1
SelX9Xmsd | 100 | Select X9 reg source from X reg MSD | Branches (D3:D0) | FixDP | 0000 | Select the DP status bit
SelYXlsd | 101 | Select Y reg source from X reg LSD | | SignXexp | 0001 | Select the Op2 exponent sign status bit
CntrIncr | 110 | Increment selected and enabled counter | | NegExpTerm | 0010 | Select the negative exponent accumulation terminated status bit
RowHold | 111 | DSKY row latch disable (hold)
SelYZero | 000 | Select Y reg MSD source from 0
SelQZero | 000 | Select Q reg MSD source from 0
SelX9Zero | 000 | Select X9 reg source from 0
SelQLZero | 000 | Select QL reg source from 0
CircX | 000001 | Shift X reg from MSD toward LSD
DPAdjX | 000001
ShrX | 000001
EntNumX | 000010 | Shift X reg from LSD toward MSD
LeftJustX | 000010
ApendDivdn | 000010
RmLdZeroX | 000010
DPAdjY | 000100 | Shift X reg from MSD toward LSD
CopyXY | 000101 | Shift X and Y reg from MSD toward LSD
ExchXY | 000101
AddSub | 000101
DivXY10 | 000101
ShrX9X8QDiv10 | 010001 | Shift X and Q reg from MSD toward LSD
CopyYQ | 010100 | Shift Y and Q reg from MSD toward LSD
CopyQ0QL | 100000 | Shift Q reg from LSD toward MSD
CopyQX | 100010 | Shift X and Q reg from LSD toward MSD
JMP | NA | Unconditional Branch
BRDecEven | 0000 | Branch if DexpCnt=0
BRDigFull | 0001 | Branch of DigCnt=8
BRDigEmpty | 0010 | Branch if DigCnt=0
BRDintOvrfl | 0011 | Branch if Dexp>=8
BRSignX | 0100 | Branch if SignX status bit set
BRSignY | 0101 | Branch if SignY status bit set
BRInOp2Ph | 0110 | Branch if in or beyond Op2Ph tracking state
BRDPFree | 0111 | Branch of DP status bit has not been set
BRQLZero | 1000 | Branch if Qlreg=0
BRX9Zero | 1001 | Branch if X9reg=0
BRDpOvrfl | 1010 | Branch if XDpCnt>=8
BRNoKeyDet | 1011 | Branch if no key is currently pressed
BRIsNeg | 1100 | Branch if arithmetic (SUM) sign bit is set
BRCarryO | 1101 | Branch if arithmetic carry out bit is set
BRSignXexp | 1110 | Branch if Op2’s exponent sign status bit is set
BRLoop8NZ | 1111 | Branch if LoopCnt>0
BRSignYexp | 0110 | Branch if Op1’s exponent sign status bit is set
BrNegExpTerm | 0101 | Branch if current negative exponent calculated
0 | 0000 | Immedate data 0
1 | 0001 | Immedate data 1
2 | 0010 | Immedate data 2
3 | 0011 | Immedate data 3
4 | 0100 | Immedate data 4
5 | 0101 | Immedate data 5
6 | 0110 | Immedate data 6
7 | 0111 | Immedate data 7
8 | 1000 | Immedate data 8
9 | 1001 | Immedate data 9
XDigCnt | 0001 | Select the XDigit counter
XDPCnt | 0010 | Select the XDP counter
XYDexpCnt | 0011 | Select the Dexp counter
XYSexpCnt | 0100 | Select the Sexp counter
X9Cnt | 0101 | Select the X9 counter
QLCnt | 0110 | Select the QL counter
SignX | 0011 | Select the Op2 sign status bit
SignY | 0100 | Select the Op1 sign status bit
SignYexp | 0101 | Select the Op1 exponent sign status bit
AssertError | 0110 | Select the Error status bit

SelCtl1 (I5br:I7)

SelCtl2 (I16:I18)

SelCtl3 (I19:I21)

RegCmd (I8:I13)
Immediate Data Labels (D3:D0)

# MicroInstruction Fields

SubAddB | 0 | Add Digit 0 of Y register with Digit 0 of X register
1 | Subtract Digit 0 of X register from Digit 0 of Y register
CarryEn | 0 | Disable Carry In to Adder/Subtractor for one instruction
| 1 | Enable Carry In to Adder/Subtractor for one instruction
KeyAck | 0 | NA
| 1 | Write state of keyboard into keyboard register, reset sequencer loop counter
HWIntEn | 0 | NA
| 1 | Enable branch to interrupt service routine if HWInt is active for one instruction

Add/Sub (I14:I15)

SEQ/DSKY (I22:I23)

## Reset Vector

## Interrupt Vector Table

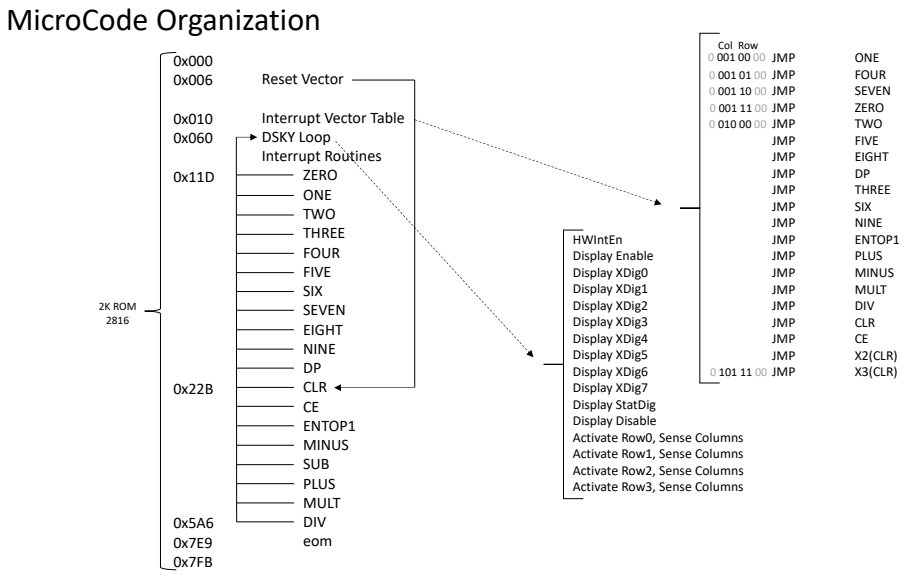
[picture p17: page 27]
DSKY Loop Interrupt Routines ZERO ONE TWO THREE FOUR FIVE SIX SEVEN EIGHT NINE DP CLR CE ENTOP1 MINUS SUB PLUS MULT DIV eom; JMP; ONE; FOUR; SEVEN; ZERO; TWO; FIVE; EIGHT; THREE; SIX; NINE; ENTOP1; PLUS; MINUS; MULT; DIV; CLR; X2(CLR); X3(CLR); MicroCode Organization; Col Row; 2K ROM 2816

HWIntEn
Display Enable
Display XDig0
Display XDig1
Display XDig2
Display XDig3
Display XDig4
Display XDig5
Display XDig6
Display XDig7
Display StatDig
Display Disable
Activate Row0, Sense Columns
Activate Row1, Sense Columns
Activate Row2, Sense Columns
Activate Row3, Sense Columns

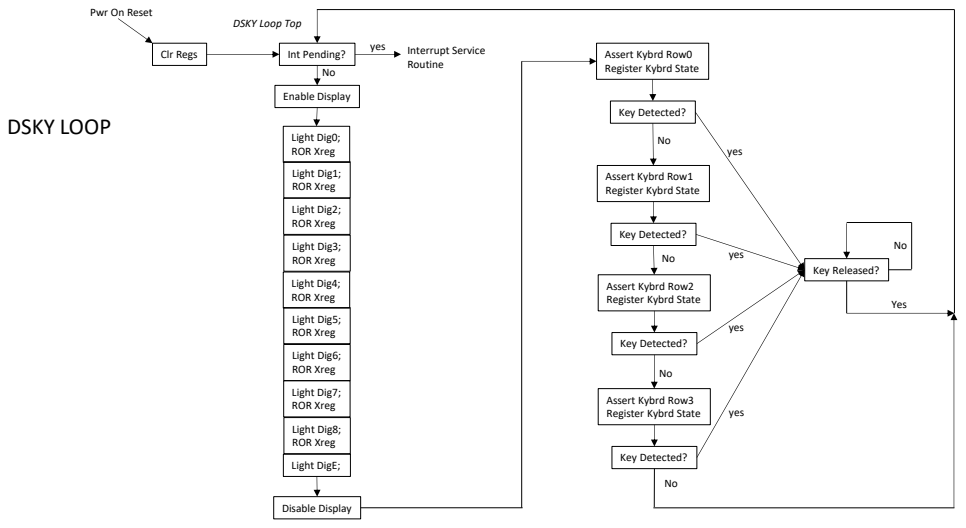
[picture p18: page 28]
DSKY LOOP; Int Pending?; Light Dig0; ROR Xreg; Light DigE;; Key Detected?; Key Released?; Enable Display; Disable Display; Light Dig1; ROR Xreg; Light Dig7; ROR Xreg; Light Dig2; ROR Xreg; Light Dig3; ROR Xreg; Light Dig4; ROR Xreg; Light Dig5; ROR Xreg; Light Dig6; ROR Xreg; Light Dig8; ROR Xreg; Clr Regs; Yes; yes; Interrupt Service; Routine

Pwr On Reset

DSKY Loop Top

Assert Kybrd Row0
Register Kybrd State

Assert Kybrd Row1

Assert Kybrd Row2

Assert Kybrd Row3

## 1-9 Service Routine

## Dp Service Routine

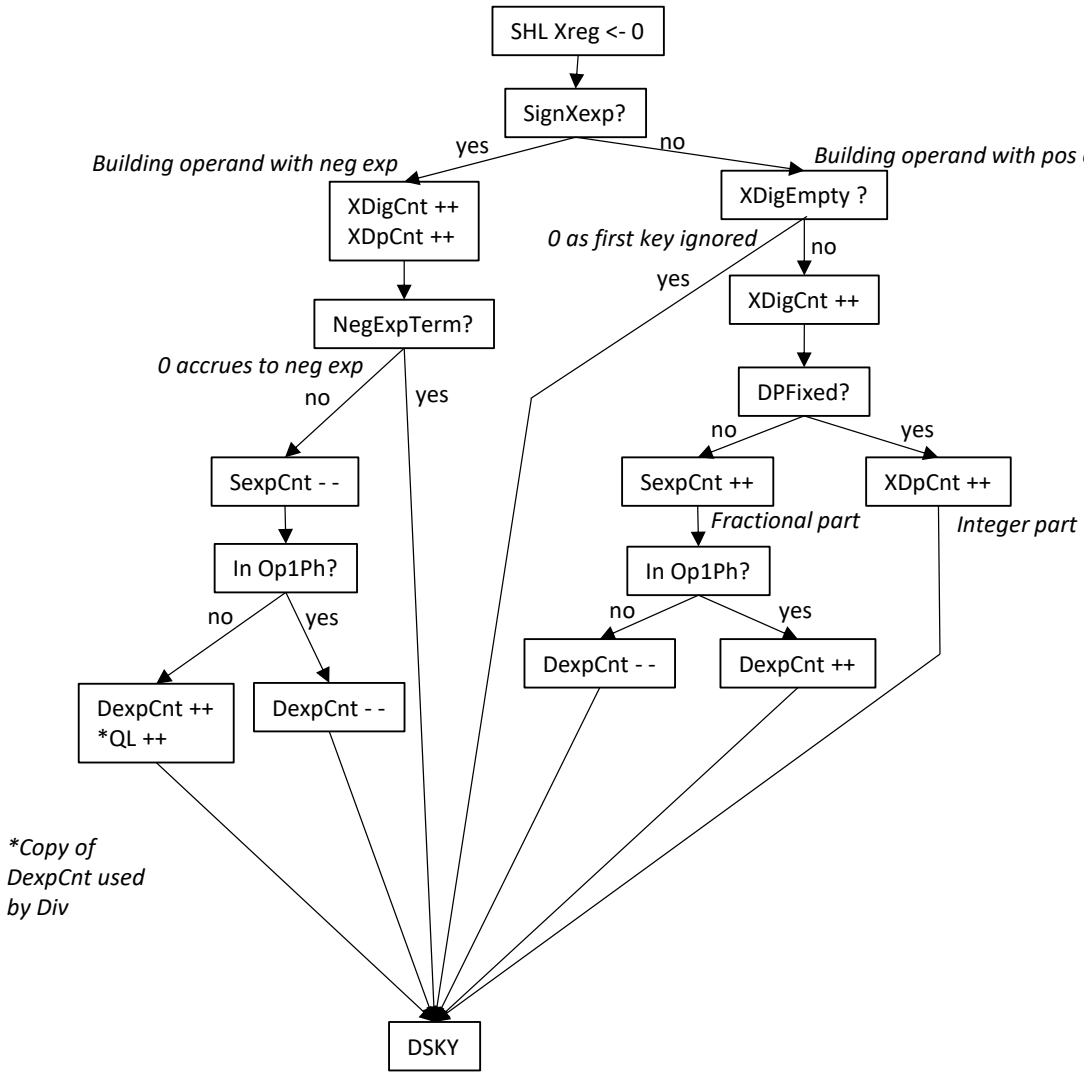
[picture p19: figure]
SHL Xreg <- 0; SignXexp?; XDigEmpty ?; DSKY; XDigCnt ++; DPFixed?; SexpCnt ++; XDpCnt ++; DexpCnt - -; DexpCnt ++; XDigCnt ++ XDpCnt ++; NegExpTerm?; SexpCnt - -; yes; 0 as first key ignored; Fractional part; Integer part; 0 accrues to neg exp; *Copy of DexpCnt used by Div
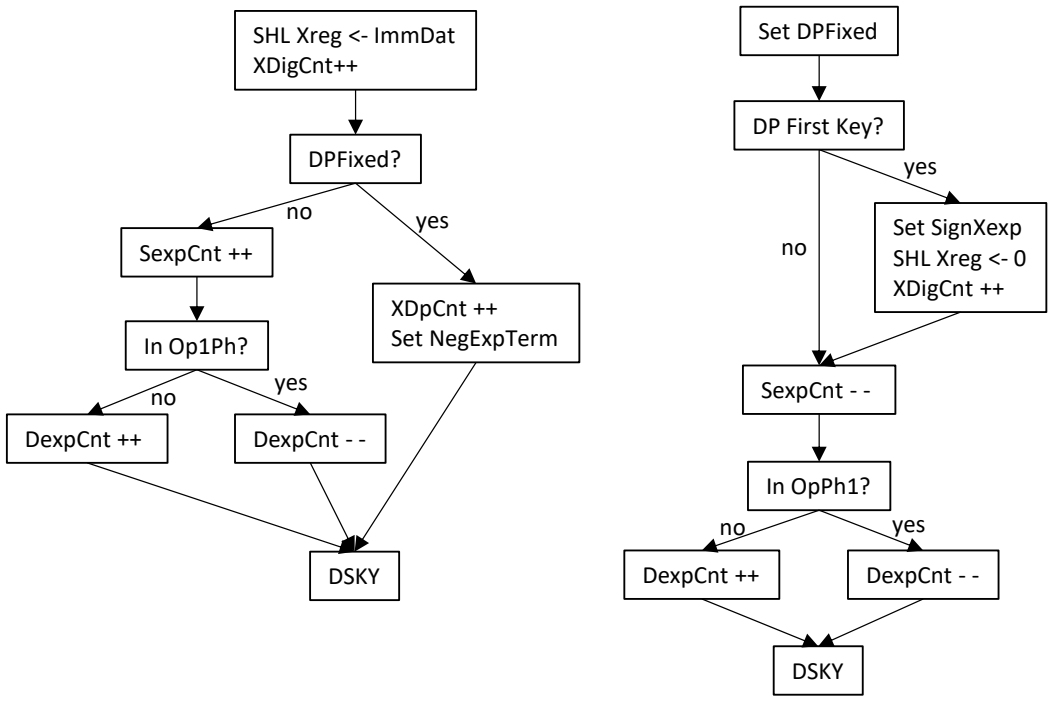
[picture p20: figure]
SHL Xreg <- ImmDat XDigCnt++; DPFixed?; SexpCnt ++; DexpCnt ++; DexpCnt - -; XDpCnt ++ Set NegExpTerm; DSKY; yes no; yes; Set DPFixed; DP First Key?; Set SignXexp SHL Xreg <- 0 XDigCnt ++; SexpCnt - -; In OpPh1?

Building operand with pos exp Building operand with neg exp

## Zero Service Routine

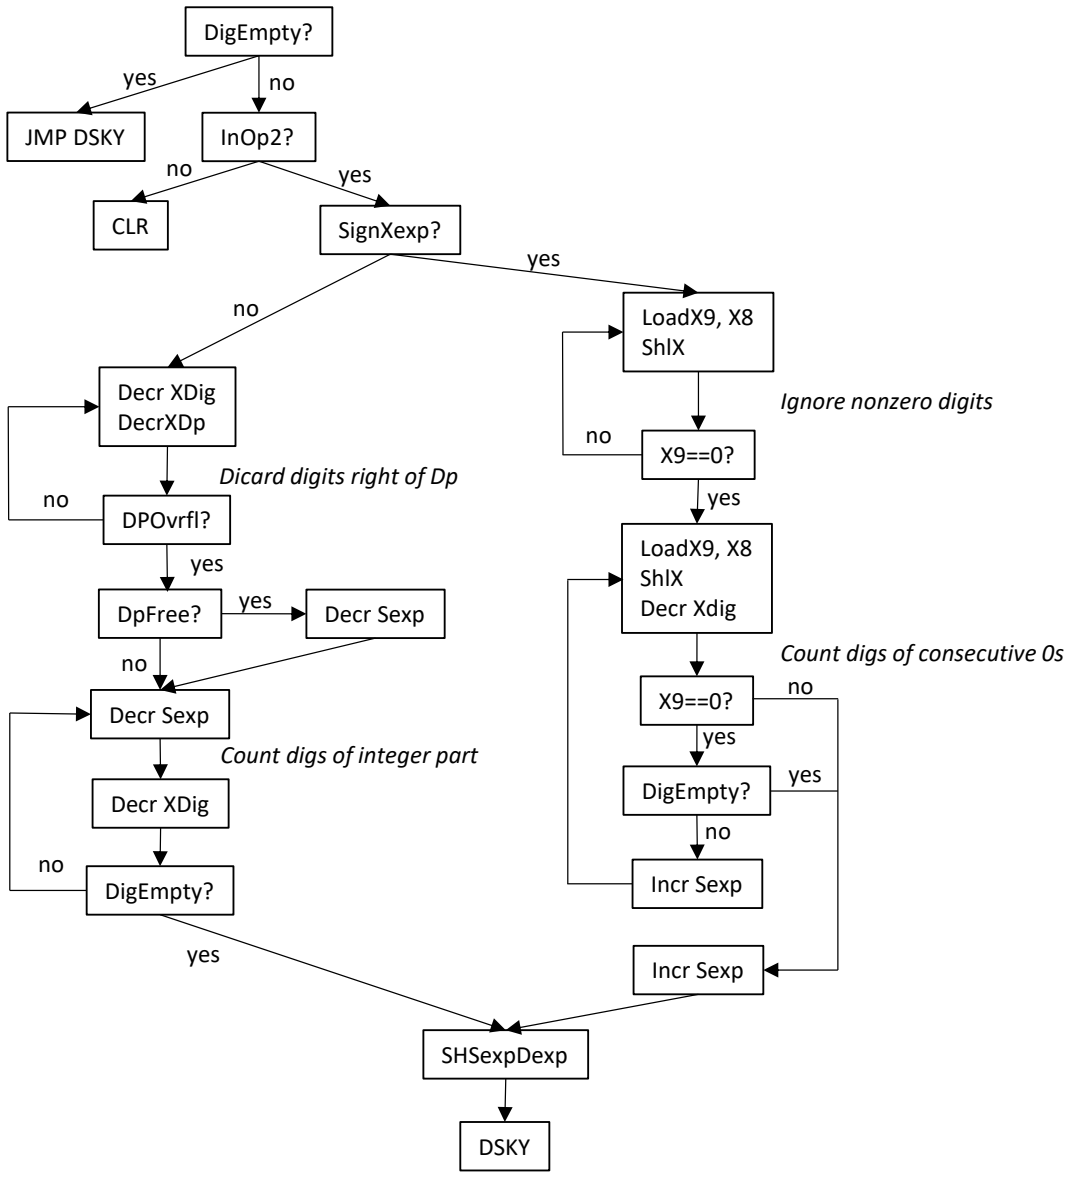
[picture p21: figure]
InOp2?; CLR; SignXexp?; Decr XDig DecrXDp; DPOvrfl?; DigEmpty?; JMP DSKY; yes; Dicard digits right of Dp; Decr Sexp; Count digs of integer part; Decr XDig; SHSexpDexp; Ignore nonzero digits; Count digs of consecutive 0s; DpFree?; LoadX9, X8 ShlX; LoadX9, X8 ShlX Decr Xdig; Incr Sexp; DSKY

## Enter Op1 Service Routine

## CE Service Routine

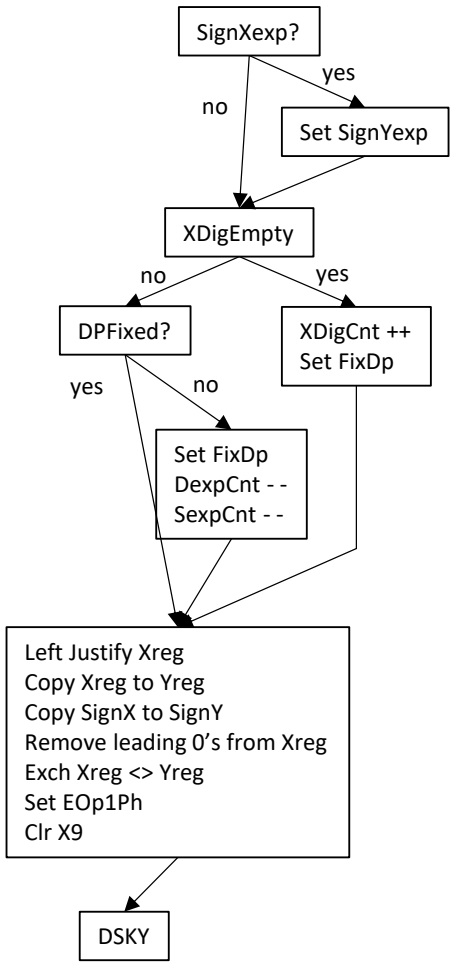
[picture p22: figure]
SignXexp?; Set SignYexp; XDigEmpty; XDigCnt ++ Set FixDp; DPFixed?; Set FixDp DexpCnt - - SexpCnt - -; yes; Left Justify Xreg Copy Xreg to Yreg Copy SignX to SignY Remove leading 0’s from Xreg Exch Xreg <> Yreg Set EOp1Ph Clr X9; DSKY

### Basic Register Model

# Mult Add or Sub

# Div

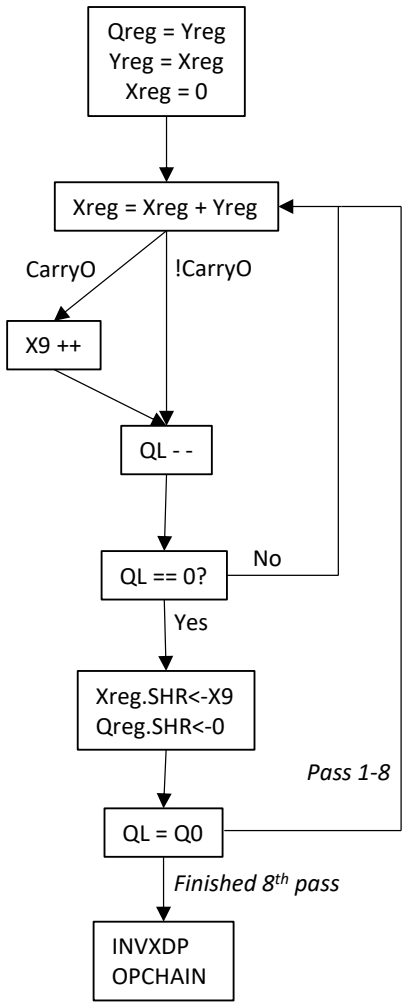
[picture p23: figure]
Qreg = Yreg Yreg = Xreg Xreg = 0; Xreg = Xreg + Yreg; Xreg.SHR<-X9 Qreg.SHR<-0; Yes; INVXDP OPCHAIN; CarryO; !CarryO; Finished 8th pass; Pass 1-8
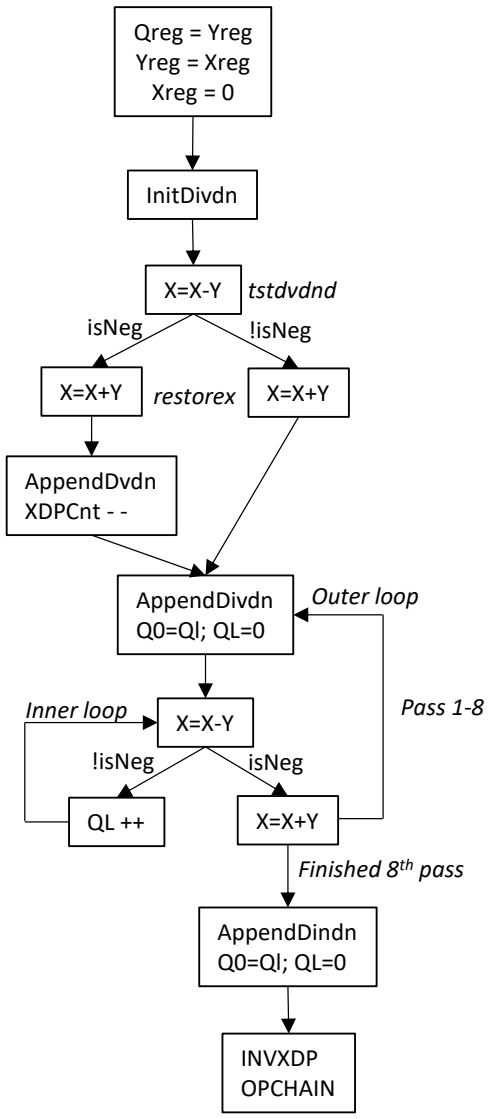
[picture p24: figure]
Inner loop; AppendDivdn Q0=Ql; QL=0; isNeg; Finished 8th pass; AppendDindn Q0=Ql; QL=0; INVXDP OPCHAIN; InitDivdn; AppendDvdn XDPCnt - -; tstdvdnd; restorex; Qreg = Yreg Yreg = Xreg Xreg = 0; Pass 1-8; Outer loop; !isNeg
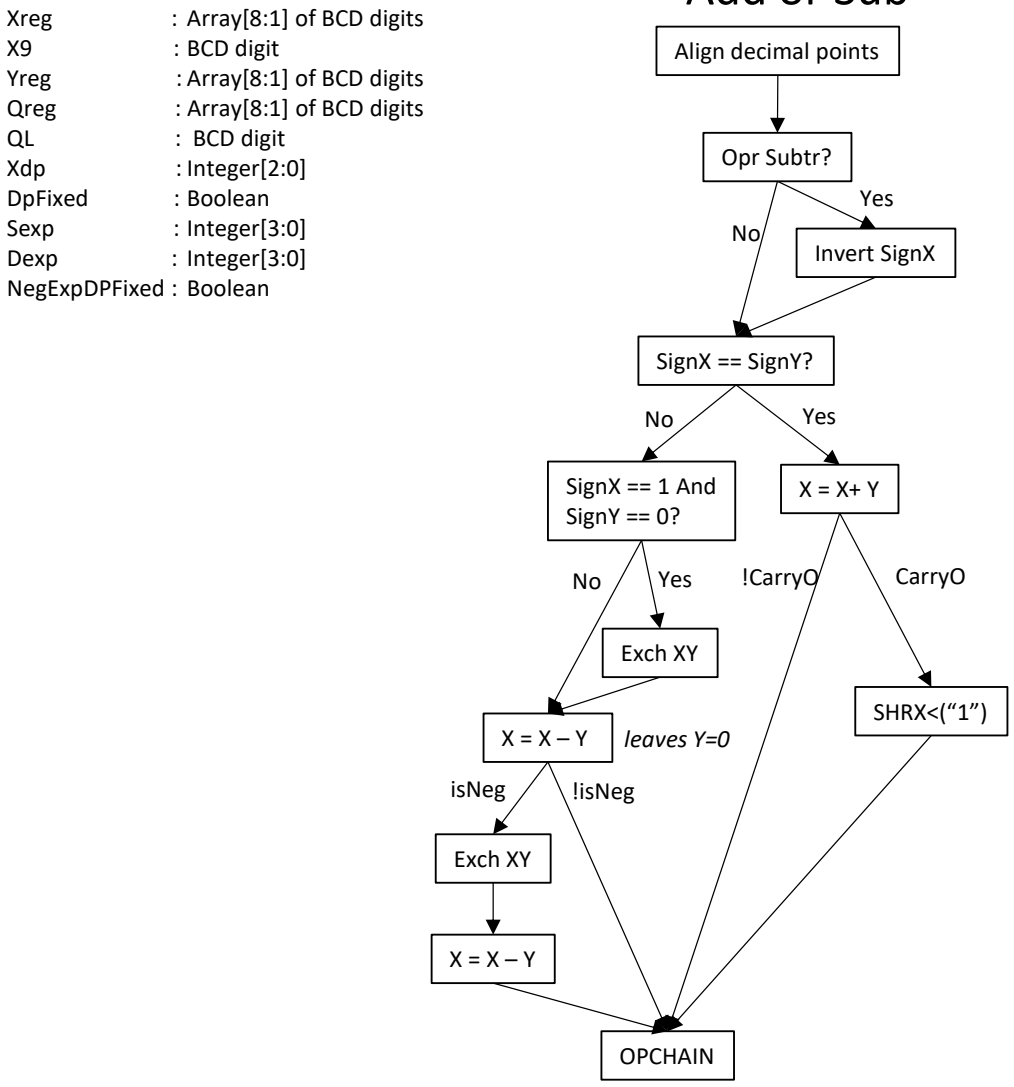
[picture p25: figure]
Xreg; : Array[8:1] of BCD digits; : BCD digit; Yreg; Qreg; Xdp; : Integer[2:0]; DpFixed; : Boolean; Sexp; : Integer[3:0]; Dexp; NegExpDPFixed : Boolean; Align decimal points; Opr Subtr?; Invert SignX; SignX == SignY?; SignX == 1 And; SignY == 0?; Exch XY; OPCHAIN; Yes; SHRX<(“1”); !CarryO; CarryO; isNeg; leaves Y=0; !isNeg

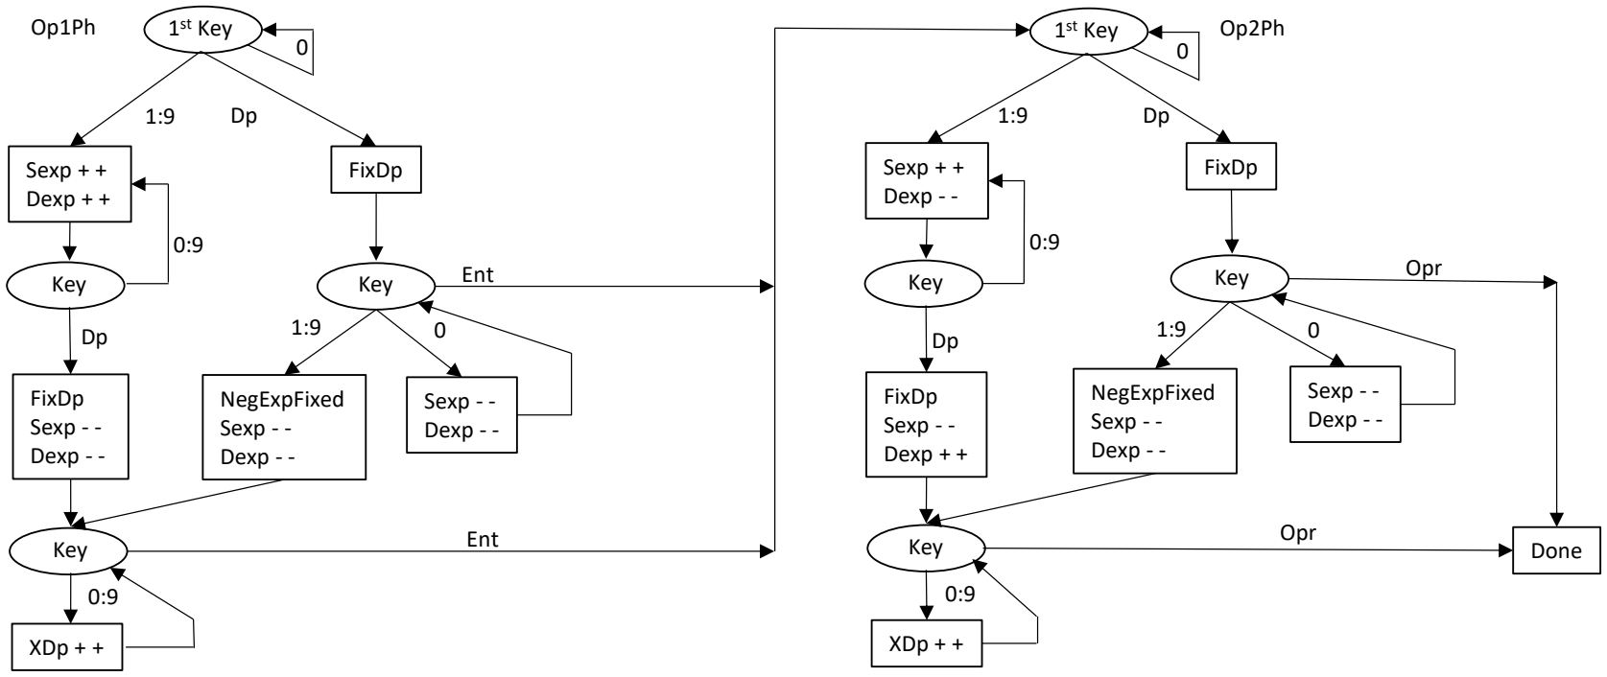
[picture p26: figure]
Sexp + +; FixDp; Dexp + +; FixDp Sexp - - Dexp - -; Key; st Key; NegExpFixed Sexp - - Dexp - -; Sexp - - Dexp - -; Ent; Dexp - -; FixDp Sexp - - Dexp + +; Opr; XDp + +; Done

Mult
Pos Exp: XDp placement is initialized by Sexp. Incremented once (XDp shifted right one digit) if the final Mult loop leaves a non-zero accumulation of CarryOs in X9.
Neg Exp: XDp placed in left most position. Sexp number of leading zeros right shifted into MSD of product, losing right most digits for each shift.

Div:
Pos Exp: XDp placement is initialized by Dexp. Decremented once (XDp shifted left one digit) if the minimum number of dividend digits needed to subtract the divisor with a positive result is one more than the divisor digits.
NegExp: XDp placed in left most position. Dexp number of leading zeros right shifted into MSD, losing rightmost digits for each shift.

Add/Sub:
If Dexp <= 0, then XDp = XDp(Op2) else XDp = XDp(Op2) + Dexp.

# Exponent Computation (XDp Placement)

# Operation Chaining

(Post processing the result of an

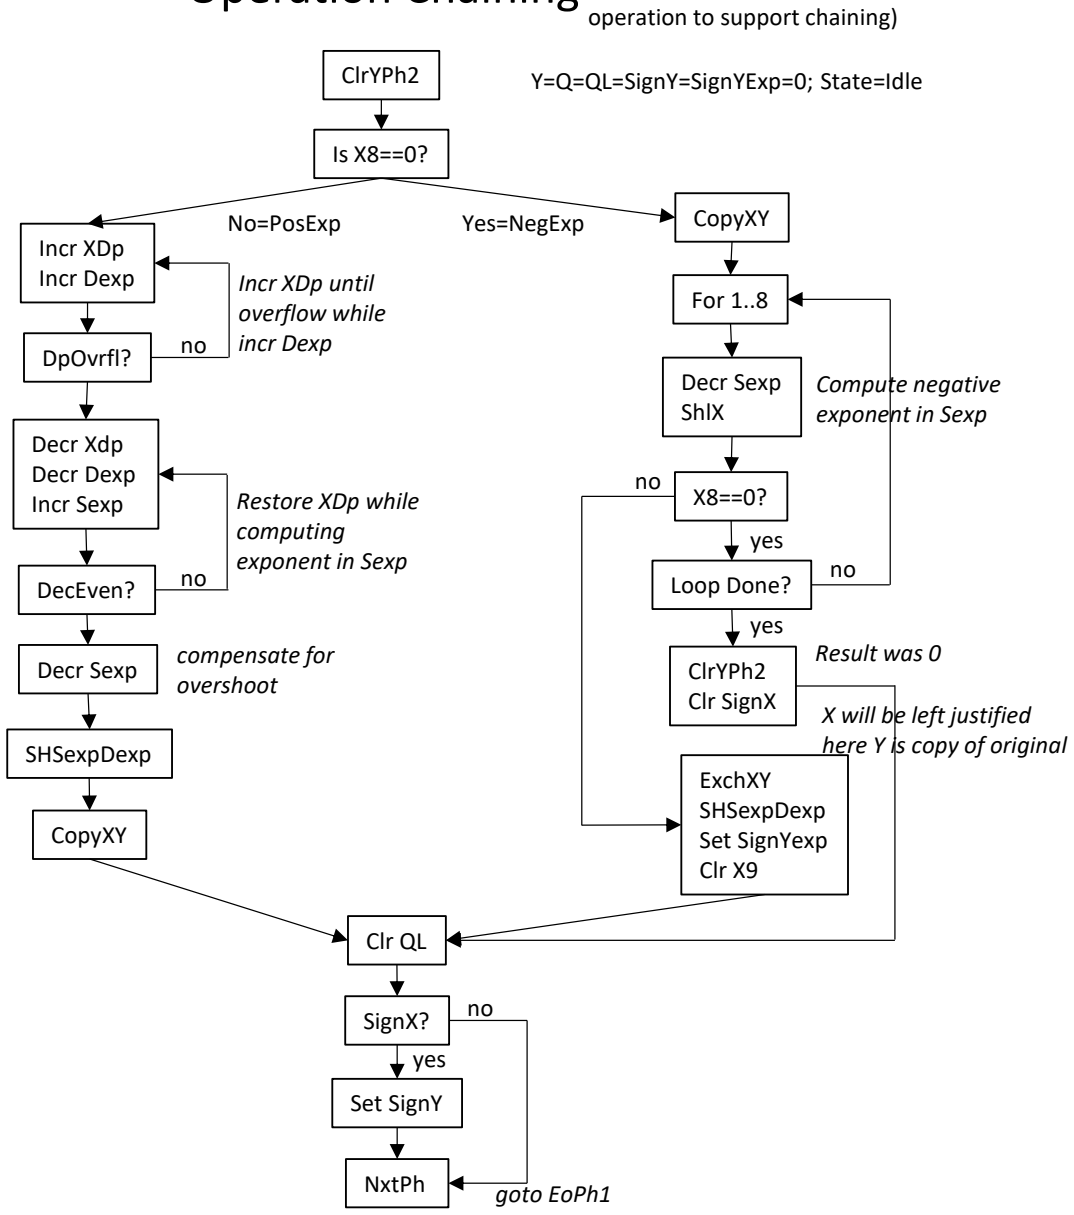
[picture p27: figure]
ClrYPh2; No=PosExp; Yes=NegExp; Y=Q=QL=SignY=SignYExp=0; State=Idle; Incr XDp until overflow while incr Dexp; compensate for overshoot; CopyXY; goto EoPh1; Decr Sexp ShlX; ExchXY SHSexpDexp Set SignYexp Clr X9; Compute negative exponent in Sexp; X will be left justified here Y is copy of original; yes; NxtPh; Incr XDp Incr Dexp; Decr Xdp Decr Dexp Incr Sexp; DpOvrfl?; DecEven?; Decr Sexp; SHSexpDexp; Restore XDp while computing exponent in Sexp; For 1..8; Loop Done?; ClrYPh2 Clr SignX; Clr QL; SignX?; Set SignY; Result was 0; operation to support chaining)

# Invert XDP

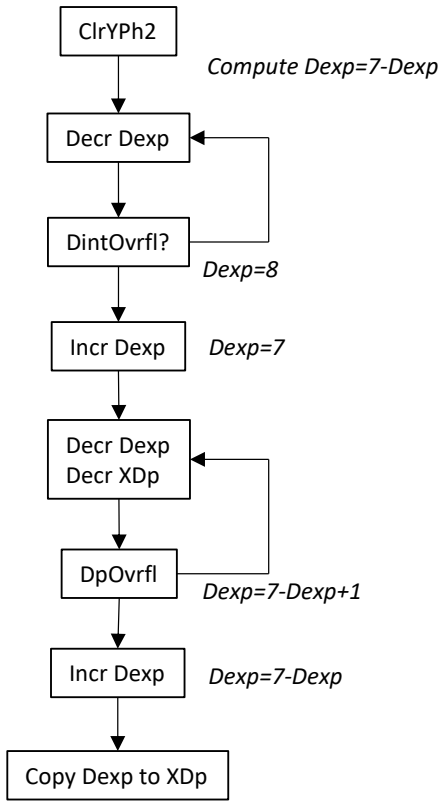
[picture p28: figure]
ClrYPh2; Decr Dexp; DintOvrfl?; Incr Dexp; Decr Dexp Decr XDp; DpOvrfl; Copy Dexp to XDp; Compute Dexp=7-Dexp; Dexp=8; Dexp=7; Dexp=7-Dexp+1; Dexp=7-Dexp

# 1-9 Service Routine

SHL <num> into Xreg
Incr XdigCnt
If Dp_Not_Fixed then
Incr SexpCnt
If Op1Ph then
Incr DexpCnt
Else
Decr DexpCnt
Else | // Dp Fixed. Key hits no longer
| // accumulate exponents
Incr XDpCnt
Set NegExpTerm // Indicate negative exponent
| //accumulation terminated

# Dp Service Routine

Set FixDp
If Dp is first key hit then
Set SignXexp
SHL “0” into Xreg
Incr XDigCnt
Decr SexpCnt
If Op1Ph then
Decr DexpCnt
Else
Incr DexpCnt
JMP DSKY

# Zero Service Routine

SHL “0” int Xreg
If Not SignXexp then // If Xreg is > 1
If XDigEmpty then // And Xreg is empty
JMP DSKY | // Then key hit can be ignored
Else | // Building operand > 1
Incr XdigCnt
If DpFixed Then // Building the fractional part Incr XDp Cnt
JMP DSKY
Else | // Building the integer part
Incr SexpCnt
If Op1Ph Then
Incr DexpCnt
Else
Decr DexpCnt
JMP DSKY
Else | // Building operand < 1
Incr XdigCnt
Incr XDpCnt
If NegExpTerm Then // If no more leading 0’s then done JMP DSKY
Else | // Account for the larger negative exponent
Decr SexpCnt
If Op1Ph Then
Decr DexpCnt
Else
Incr DexpCnt
Incr QL | // QL used to mirror DexpCnt count
| // of leading 0’s (used by Div)
JMP DSKY

# Enter Op1 Service Routine

If Dp was first key hit then // Xreg < than 1 Set SignYexp bit
If no numeric key was hit then
Incr XDigCnt; Set FixDp
Else
If Dp was not hit then // Xreg is pure integer Ser FixDp; Dexp - -; Sexp - -
While not XDigFull | // Left justify Xreg
SHL Xreg <- 0; XdigCnt ++; XDPCnt ++ Copy_Xreg_into_Yreg
Copy SignX into SignY
X9 <- Xmsd // Remove leading zeros. Does nothing //unless operand is < 1.
While X9 == 0 | // The operand in X is mantissa
X9 <- SHL Xreg <- 0 // The operand in Y is displayable version Exchange Xreg<>Yreg
NxtPh | // Move to EOp1Ph
Clear X9
JMP DSKY

# DSKY Loop

Do Forever
If HWInt Then
JMP IntTbl[IV]
Enable Disp
For (Digit 0 to 7)
Select Digit
ROR Xreg
Sel StatDigit
Disable Disp
For (Row 0 to 3)
If DetectKey
Wait Until KeyReleased

// Execute key routine

// Light each digit

// Scan keyboard

MINUS
If Not Op2Ph Then // If not in Op2 then “-” means sign bit Set SignX
JMP DSKY
Else | // If in Op2 then “-” means subtract
Invert_SignX
PLUS
If DigEmpty Then // If no key hit for Op2 then enter “0” Incr XDigCnt
Set FixDp
Else
If DpFree Then // Op2 is pure integer, fix Dp and adj exp Set FixDp
Decr SexpCnt
Incr DexpCnt
Left_Justify_Xreg
While X8 == 0 | // Remove leading 0’s from Op2<1
SHL Xreg, 0
Incr XDpCnt
While DexpCnt != 0 // Get operands exponent-aligned (DpAdj) If DintOvrfl Then // Shift Yreg right, count Dexp up
SHR Yreg, 0
Incr DexpCnt
Else | // Shift Xreg right, count Dexp down
SHR Xreg, 0
Decr DexpCnt
While DpOvrfl | // Restore leading 0’s to Op2, if any
SHR Xreg; SHR Yreg
Decr XDpCnt
If (SignX XOR SignY) == 0 Then // If Op signs same, then ADD Xreg = Xreg + Yreg
If CarryO Then // If final carry out then shift in X9, adj XDp Incr X9
SHR Xreg, X9
Decr XDpCnt
Else | // Op signs are different
If (Sign X == 1 AND SignY == 0) Then // Yreg must be the negative op for ALU Exch Xreg<>Yreg
Exch SignX<>SignY
Xreg = Xreg – Yreg
If DpOvrfl Then
Set Error
JMP DSKY

OPADD (Xreg + Yreg)
SHR Xreg, Sum; SHR Yreg, 0; ADD | // Shift Xreg and Yreg right,
SHR Xreg, Sum; SHR Yreg, 0; ADD, CarryEn // with Lsd’s going through ALU SHR Xreg, Sum; SHR Yreg, 0; ADD, CarryEn // and the Sum shifting into SHR Xreg, Sum; SHR Yreg, 0; ADD, CarryEn // Xreg msd, and 0’s shifting SHR Xreg, Sum; SHR Yreg, 0; ADD, CarryEn // into Yreg msd
SHR Xreg, Sum; SHR Yreg, 0; ADD, CarryEn
SHR Xreg, Sum; SHR Yreg, 0; ADD, CarryEn
SHR Xreg, Sum; SHR Yreg, 0; ADD, CarryEn

OPSUB (Xreg – Yreg)
SHR Xreg, Sum; SHR Yreg, 0; SUB
SHR Xreg, Sum; SHR Yreg, 0; SUB, CarryEn SHR Xreg, Sum; SHR Yreg, 0; SUB, CarryEn SHR Xreg, Sum; SHR Yreg, 0; SUB, CarryEn SHR Xreg, Sum; SHR Yreg, 0; SUB, CarryEn SHR Xreg, Sum; SHR Yreg, 0; SUB, CarryEn
SHR Xreg, Sum; SHR Yreg, 0; SUB, CarryEn
SHR Xreg, Sum; SHR Yreg, 0; SUB, CarryEn
If IsNeg Then // Get 10’s complement and BCD adjust Exch Xreg<>Yreg
SHR Xreg, Sum; SHR Yreg, 0; SUB
SHR Xreg, Sum; SHR Yreg, 0; SUB, CarryEn
SHR Xreg, Sum; SHR Yreg, 0; SUB, CarryEn SHR Xreg, Sum; SHR Yreg, 0; SUB, CarryEn SHR Xreg, Sum; SHR Yreg, 0; SUB, CarryEn SHR Xreg, Sum; SHR Yreg, 0; SUB, CarryEn SHR Xreg, Sum; SHR Yreg, 0; SUB, CarryEn
SHR Xreg, Sum; SHR Yreg, 0; SUB, CarryEn
Set SignX // Since result is negative
While X8 == 0 AND NOT DpOvrfl // Remove excess leading 0’s, if any SHL Xreg, 0
Incr XDpCnt

## Add and Subtract Service Routine

If DigEmpty Then // If no key hit for Op2 then enter “0” Incr XDigCnt
Set FixDp
Else
If DPFree Then // Else if Dp not hit then FixDp and adj exps Set FixDp
Decr SexpCnt
Incr DexpCnt
Left_Justify_Xreg
While X8 == 0 // Remove any leading 0’s in Op2 SHL Xreg, 0; Incr XDpCnt
NxtPh | // Move to OprPh
If (SignX XOR SignY) == 1 Then
Set SignX
Else
Clear SignX
Copy Yreg to Qreg // Get regs set up for Mult loop
Copy Xreg to Yreg, clearing Xreg
Mult_Loop
If (SignXexp == SignYexp == 0 AND DpOvrfl) Then // Overflow handler Set Error
JMP DSKY
If (SignXexp == SignYexp == 1 AND DpOvrfl) Then // Underflow handler ClrXPh
JMP DSKY
If DpOvrfl Then // Product is <1
While DpOvrfl // Insert leading 0’s to product <1 SHR Xreg, 0 // leaving XDP at 0 (7 after inv)
Incr XDpCnt
Else | // Product is >1
While X8 == 0 // Remove leading 0’s to product >1, if any SHL Xreg, 0
Decr XDpCnt // Move Dp to the left
Invert XDpCnt
JMP DSKY

Copy Q0 into QL; SHR Qreg
NxtPh | // Move to MultDivPh
Shift SexpCnt into XDpCnt | // SexpCnt has the DP placement for product
For 8 Loops
While QL != 0
SHR Xreg, Sum; SHR Yreg, Y0; ADD | // Shift Xreg and Yreg right,
SHR Xreg, Sum; SHR Yreg, Y0; ADD, CarryEn // with Xmsd getting getting the Sum SHR Xreg, Sum; SHR Yreg, Y0; ADD, CarryEn // and Ymsd circulating Ylsd
SHR Xreg, Sum; SHR Yreg, Y0; ADD, CarryEn
SHR Xreg, Sum; SHR Yreg, Y0; ADD, CarryEn
SHR Xreg, Sum; SHR Yreg, Y0; ADD, CarryEn
SHR Xreg, Sum; SHR Yreg, Y0; ADD, CarryEn SHR Xreg, Sum; SHR Yreg, Y0; ADD, CarryEn If CarryO Then
Incr X9
Decr QL
SHR Xreg, X9; SHR Qreg, 0
Clr X9
If X9 != 0 Then
SHR Xreg, X9
Incr XDpCnt

## Mult Service Routine

For 8 Loops | // Check for Op2==0
Load X8 into X9
If X9 == 0 Then
SHR Xreg, X1
Else Continue DPCHK
Set Error
JMP DSKY
If NOT DpFixed Then | // If Dp never entered
Set FixDp | // Fix Dp and exp adj
Decr SexpCnt
Incr DexpCnt
NxtPh | // Move to OprPh
If (SignX XOR SignY) == 0 Then // Compute sign of quotient Clear SignX
Else
Set SignX
If Op2 < 1 Then // Divide both ops by 10 if Xreg is full If DigFull Then
SHR Xreg, 0; SHR Y, 0
Copy Yreg to Qreg
Copy Xreg to Yreg, clearing Xreg
Move to MultDivPh
Copy DexpCnt to XDpCnt // Exponent for quotient is DexpCnt If SignXexp Then // Remove the extra “0” in front of Dp
Decr XDigCnt
While QL != 0
Decr QL // QL is a copy of DexpCnt to use for removing leading 0’s Decr XDigCnt
While NOT DigEmpty // Init dividend with XDigCnt digits of Qreg
SHL Xreg, Q8; SHL Qreg, 0
Decr XDigCnt
X = X-Y | // Begin test if one more dividend digit is needed
If IsNeg Then
X = X+Y // Restore dividend
SHL Xreg, Q8; SHL Qreg, 0 // Add one more digit to dividend Decr XDpCnt
Else
X = X+Y // Restore dividend

DPCHK

For 8 Loops // outer loop
SHL Xreg, Q8 | // Append dividend with additional digit
SHL Qreg, 0; Copy QL to Q0 // Accumulate quotient
Clr QL
While 1 // Inner loop
X = X – Y
If isNeg Break
Incr QL
X = X+Y
SHL Qreg, 0; Copy QL to Q0
Clr QL
Copy Qreg to Xreg // Copy quotient to Xreg
If (SignYexp == 1 AND SignXexp == 0) Then // Underflow handler If DPOvrfl Then
Clr Xreg
JMP DSKY
If (SignXexp == 1 AND SignYexp) == 0 Then // Overflow Handler If DPOvrfl Then
Set Error
JMP DSKY
If NOT DPOvrfl Then // Quotient >=1; Done JMP DSKY
Repeat
SHR Xreg, 0
Incr XDpCnt
Until DPOvrfl
Invert XDpCnt
JMP DSKY

## Div Service Routine

If Xreg is empty then
JMP DSKY
If in Op1Ph then
JMP CLR
Else
If SignXexp then // Back out the negative exponent While Xmsd != 0 // Shift out leading Fs
SHL Xreg <- 0
While (Xmsd == 0) AND (not XDigEmpty) // Count
XDigCnt - - | // leading 0 digits and
XYSexpCnt ++ | // back out Op2 exponent
XYSexpCnt ++
Else | // Back out the positive exponent
Repeat | // Remove fractional part of operand from XDigCnt
XDpCnt - -
XDigCnt - -
Until (DpOvrfl)
If not DpFixed then
XYSexpCnt - - | // Back out exp correction integer part
While (not DigEmpty) // Back out Op2 exponent
XYSexpCnt - -
XDigCnt - -
Copy Sexp to Dexp
ClrXPh1
Initialize Xreg with “FFFFFFF0” JMP DSKY

# CE Service Routine

JMP RESET

# CLR Service Routine

# Operation Chaining

ClrYPh2; Clr QL // Dexp and all other y regs are 0 X9 <- Xmsd
If X9 == 0 then // Negative exponent
Copy Xreg to Yreg
For 1 to 8 // Compute negative exponent XYSexpCnt - - // decrement Sexp
SHL Xreg | // and shift left X
X9 <- Xmsd | // for every leading 0
If X9 != 0 then // Done, X is left just mantissa
Exch Xreg <> Yreg // X is Leftjust mantiss, Y is display copy Copy Sexp to Dexp
Set SignYexp
Clr X9
Break to FINISH
ClrYPh2 // Result was 0
Clr SignX
Else | // Positive exponent
While (not XDpOvrfl) // compute Dexp=7-XDp
XYDexpCnt ++
XDPCnt ++
While (not DecEven) // Restore XDp and compute exp in Sexp
XDpCnt - - | // It will overshoot by 1
XYSexpCnt ++
XYDexpCnt - -
XYSexp ++ | // Fix overshoot
Copy Sexp to Dexp
Exch Xreg <> Yreg
Clr X9
If SignX then
Set SignY
Set EOPh1
JMP DSKY

FINISH

ClrYPh2
While not DintOvrfl
XYDexpCnt ++
XYDexpCnt - -
While not DpOvrfl
XYDexpCnt - -
XYSexpCnt - -
XYDexpCnt ++
Copy Dexp to XDp

# Invert XDp

# BCD Addition

## Given a 4-bit adder:

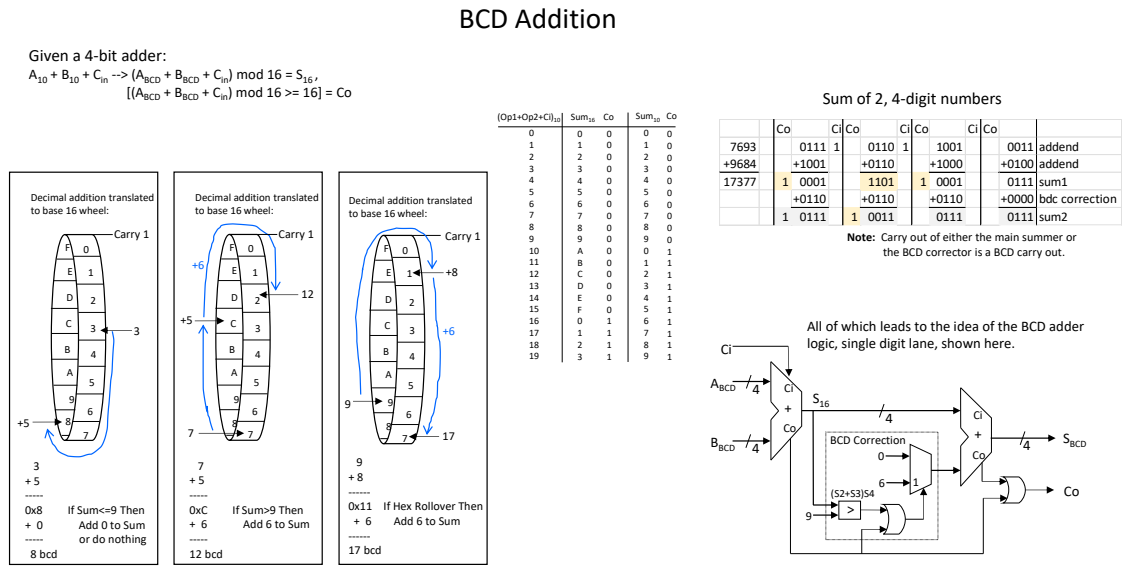
[picture p29: page 39]
bdc correction; sum2; If Sum>9 Then; Add 6 to Sum; ----- 12 bcd; Carry 1; 9 + 8 ------ 0x11 If Hex Rollover Then; ------ 17 bcd; If Sum<=9 Then; Add 0 to Sum; or do nothing; 8 bcd; Sum16; Sum10 Co; SBCD; ABCD; BBCD; BCD Correction

A10 + B10 + Cin --> (ABCD + BBCD + Cin) mod 16 = S16 ,

[(ABCD + BBCD + Cin) mod 16 >= 16] = Co

Sum of 2, 4-digit numbers

7693 | | 0111 | 1 | | 0110 | 1 | | 1001 | | | 0011 | addend
+9684 | | +1001 | | | +0110 | | | +1000 | | | +0100 | addend
17377 | 1 0001 | | | 1101 | | | 1 0001 | | | | 0111 | sum1

Decimal addition translated
to base 16 wheel:

Note: Carry out of either the main summer or
the BCD corrector is a BCD carry out.

All of which leads to the idea of the BCD adder
logic, single digit lane, shown here.

# Number Complements

# Radix complements and their sidekicks, diminished radix complements

are a numeric tool allowing subtraction be performed by addition.

- A number N, in radix R has complement numbers.
- In particular a number N in radix R has its R’s complement and its diminished R’s complement, or (R-1)’s complement.
- The R’s complement is the (R-1)’s complement plus 1.
- The (R-1)’s complement is computed by taking each digit of N and subtracting it from R-1. EX: If R=2 and N=1110, the 1’s complement is 0001,
and the 2’s complement is 0001 plus 1 or 0010.

999
-752
247

### To take the 9’s complement

of a number, say 752,

### subtract each digit of the

number from 9.

### To subtract two numbers using 9’s complement arithmetic: - Add the 9’s complement of the subtrahend to the

minuend.
- If there is a carry out of the most significant digit, then add 1 to the result. The result is positive.
- If there is no carry out of the most significant digit, the result is negative and must be 9’s complemented.

5841 – 2963 = 2878

9999
- 2963
7036
+5841
1 | 2877
1
2878

4691 – 6849 = - 2158

9999
- 6849
3150
+4691
0 | 7841

9999
-7841
- 2158

999
-750
249
+ 1
250

### To take the 10’s complement

of a number, say 750,

### subtract each digit of the number from 9 and add 1 to

the result.

### To subtract two numbers using 10’s compl. arithmetic: - Add the 10’s complement of the subtrahend to the

minuend.

### - If there is a carry out of the most significant digit, the

result is positive.

### - If there is no carry out of the most significant digit, the

result is negative and must be 10’s complemented.

5841 – 2963 = 2878

9999
- 2963
7036
+ 1
| 7037
+5841
1 | 2878

4691 – 6849 = - 2158

9999
- 6849
3150
+ 1
| 3151
+ 4691
0 | 7842

# 9’s and 10’s Complement Subtraction

9999
-7842
2157
+ 1
- 2157

9’s complement of subtrahend

Add the minuend

Add MSD carry to sum

Difference is positive

9’s complement of subtrahend

Add the minuend

Difference is negative

9’s complement of difference

10’s complement of subtrahend

Add the minuend

Difference is positive

10’s complement of subtrahend

Difference is negative

10’s comp of diff

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
Co=1
Result pos

7 - 2
(7 + 7) mod 10

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
Co=0
result is neg

-6

+1
+1

3 - 7
(3 + 3) mod 10

-4

# 10’s Complement Arithmetic With A 4-Bit Binary Adder

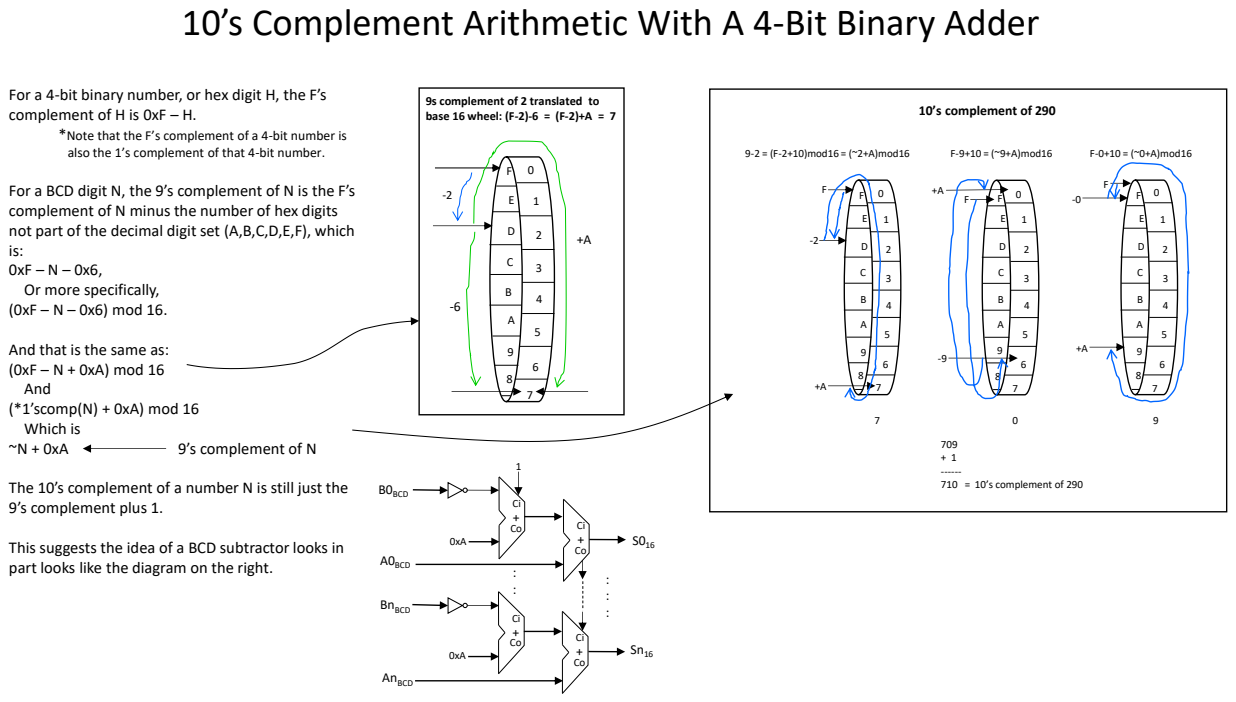
[picture p30: page 42]
9-2 = (F-2+10)mod16 = (~2+A)mod16; F-9+10 = (~9+A)mod16; 10’s complement of 290; F-0+10 = (~0+A)mod16; 709 + 1 ------ 710 = 10’s complement of 290; 9’s complement of N; A0BCD; AnBCD; B0BCD; BnBCD

For a 4-bit binary number, or hex digit H, the F’s
complement of H is 0xF – H.

9s complement of 2 translated to
base 16 wheel: (F-2)-6 = (F-2)+A = 7

*Note that the F’s complement of a 4-bit number is
also the 1’s complement of that 4-bit number.

For a BCD digit N, the 9’s complement of N is the F’s
complement of N minus the number of hex digits
not part of the decimal digit set (A,B,C,D,E,F), which
Or more specifically,
(0xF – N – 0x6) mod 16.

And that is the same as:
(0xF – N + 0xA) mod 16
And
(*1’scomp(N) + 0xA) mod 16
Which is

The 10’s complement of a number N is still just the
9’s complement plus 1.

This suggests the idea of a BCD subtractor looks in
part looks like the diagram on the right.

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
Op1-Op2 Co A + 10#(B) SUM
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
# BCD Subtraction

Co | Ci | Co | Ci
A | 47 | 0100 | 0111 | minuend
B | -28 | -0010 | -1000 | subtrahend
19
1101 | 0111 | 1's complement of subtrahend
+1010 | +1010 | 1 | add 10 (and 1 more for LSD)
1 | 0111 | 1 | 0010 | 10's complement of subtrahend
+0100 | +0111 | add minuend
1011 | 1001 | difference
+0110 | +0000 | bcd correction
1 | 0001 | 1001
Final carry=1 difference is pos (A>=B)
Co | Ci | Co | Ci
A | 28 | 0010 | 1000 | minuend
B | -41 | -0100 | -0001 | subtrahend
-13
| 1011 | | | 1110 | 1's complement of subtrahend
+1010 | +1010 | 1 | add 10 + ci
1 | 0101 | 1 | 1 | 1001 | 10's complement of subtrahend
| +0010 | | 1 | +1000 | add minuend
0 | 1000 | | | 0001 | difference
| +0000 | | | +0110 | bcd correction
| 1000 | | | 0111
Final carry=0 difference is neg (A<B)
0111 | | 1000 | | 1's complement
+1010 | | +1010 | | add 10
0001 | 1 | 0010 | | 9's complement
+0000 | | +0000 | 1 | add 1
0001 | | 0011

### A single digit BCD subtractor conceptually looks like this

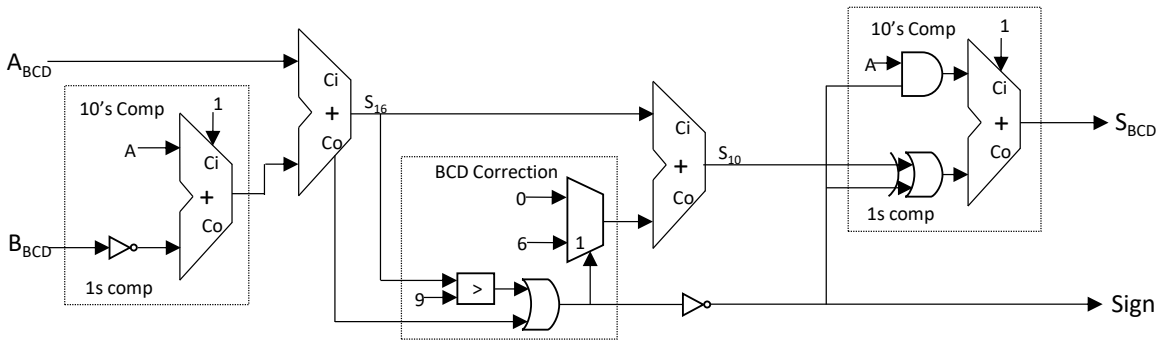
[picture p31: figure]
ABCD; BBCD; Sign; BCD Correction; 1s comp; SBCD; 10’s Comp

# Example of Combinational Three-Digit Subtractor

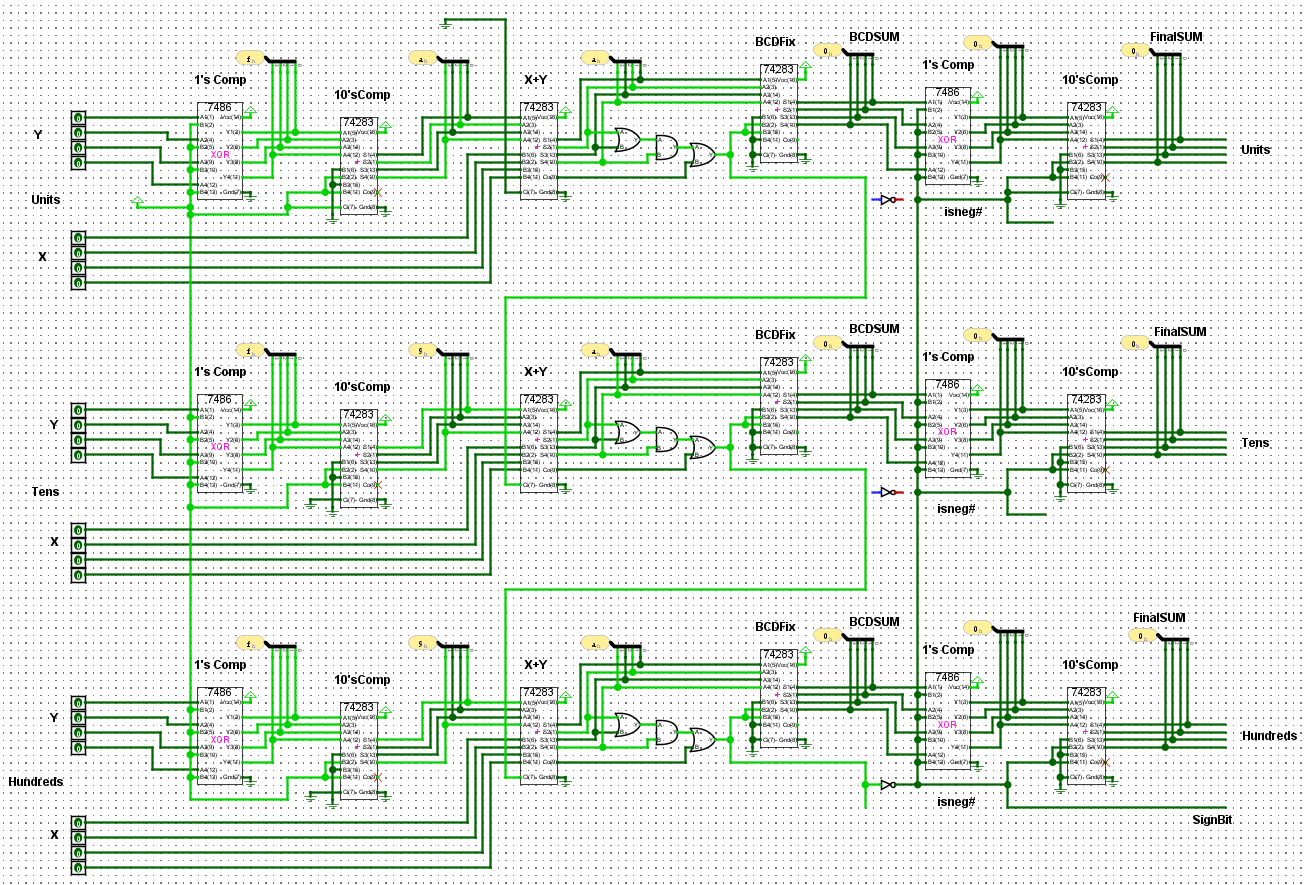
[picture p32: figure]

Overflow

Overflow happens when Sum generates a carryO of MSD.

Must detect that the insignificant Addend condition boundary crossing during second operand entry and set a bit.
Then at the start of and add, the exponent of the smallest number has to be backed out of DexpCnt and replaced with 0.

# DexpCnt For Add/Sub Overflow and Insignificant Addend (IA)

IA | IA

IA boundary

IA boundary

DexpCnt Direction

DexpCnt Direction

-14 | 0010
-13 | 0011
-12 | 0100
-11 | 0101
-10 | 0110
-9 | 0111
-8 | 1000
-7 | 1001
-6 | 1010
-5 | 1011
-4 | 1100
-3 | 1101
-2 | 1110
-1 | 1111
0 | 0000
1 | 0001
2 | 0010
3 | 0011
4 | 0100
5 | 0101
6 | 0110
7 | 0111
8 | 1000
9 | 1001
10 | 1010
11 | 1011
12 | 1100
13 | 1101
14 | 1110

Final DexpCnt
| | | pos/pos | | | | | | | neg/pos
Xreg(Op2)→ | 10000000 1000000 100000 10000 1000 100 10 1 | 0 | 0 | 0 0.0001 0.00001 0.000001 0.0000001
Yreg(Op1)↓ | 7 | 6 | 5 | 4 | 3 | 2 1 0 -1 | -2 | -3 | -4 | -5 | -6 | -7
10000000 7 | 0 | 1 | 2 | 3 | 4 | 5 6 7 | 8 | 9 | 10 | 11 | 12 | 13 | 14
1000000 6 | -1 | 0 | 1 | 2 | 3 | 4 5 6 | 7 | 8 | 9 | 10 | 11 | 12 | 13
100000 5 | -2 | -1 | 0 | 1 | 2 | 3 4 5 | 6 | 7 | 8 | 9 | 10 | 11 | 12
10000 4 | -3 | -2 | -1 | 0 | 1 | 2 3 4 | 5 | 6 | 7 | 8 | 9 | 10 | 11
1000 3 | -4 | -3 | -2 | -1 | 0 | 1 2 3 | 4 | 5 | 6 | 7 | 8 | 9 | 10
100 2 | -5 | -4 | -3 | -2 | -1 | 0 1 2 | 3 | 4 | 5 | 6 | 7 | 8 | 9
10 1 | -6 | -5 | -4 | -3 | -2 -1 0 1 | 2 | 3 | 4 | 5 | 6 | 7 | 8
1 0 | -7 | -6 | -5 | -4 | -3 -2 -1 0 | 1 | 2 | 3 | 4 | 5 | 6 | 7
0.1 -1 | -8 | -7 | -6 | -5 | -4 -3 -2 -1 | 0 | 1 | 2 | 3 | 4 | 5 | 6
0.01 -2 | -9 | -8 | -7 | -6 | -5 -4 -3 -2 | -1 | 0 | 1 | 2 | 3 | 4 | 5
0.001 -3 | -10 | -9 | -8 | -7 | -6 -5 -4 -3 | -2 | -1 | 0 | 1 | 2 | 3 | 4
0.0001 -4 | -11 | -10 | -9 | -8 | -7 -6 -5 -4 | -3 | -2 | -1 | 0 | 1 | 2 | 3
0.00001 -5 | -12 | -11 | -10 | -9 | -8 -7 -6 -5 | -4 | -3 | -2 | -1 | 0 | 1 | 2
0.000001 -6 | -13 | -12 | -11 | -10 | -9 -8 -7 -6 | -5 | -4 | -3 | -2 | -1 | 0 | 1
0.0000001 -7 | -14 | -13 | -12 | -11 -10 -9 -8 -7 | -6 | -5 | -4 | -3 | -2 | -1 | 0
| | | pos/neg | | | | | | | neg/neg

A div C… | 0.0000001 0.0000001 -7 -7 | 0.000001 0.000001 -6 -6 | 0.00001 0.00001 -5 -5 | 0.0001 0.0001 -4 -4 | 0 0 -3 -3 | 0.01 0.01 -2 -2 | 0.1 0.1 -1 -1 | 1 1 0 0 | 10 10 1 1 | 100 100 2 2 | 1000 1000 3 3 | 10000 10000 4 4 | 100000 100000 5 5 | 1000000 1000000 6 6 | 10000000 10000000 7 7
| Dexp Sexp | Dexp Sexp | Dexp Sexp | Dexp Sexp | Dexp Sexp | Dexp Sexp | Dexp Sexp | Dexp Sexp | Dexp Sexp | Dexp Sexp | Dexp Sexp | Dexp Sexp | Dexp Sexp | Dexp Sexp | Dexp Sexp
0.0000001 -7 | 0 | -14 | -1 | -13 | -2 | -12 | -3 | -11 | -4 | -10 | -5 | -9 | -6 | -8 | -7 | -7 | -8 | -6 | -9 | -5 | -10 | -4 | -11 | -3 | -12 | -2 | -13 | -1 | -14 | 0
0.000001 -6 | 1 | -13 | 0 | -12 | -1 | -11 | -2 | -10 | -3 | -9 | -4 | -8 | -5 | -7 | -6 | -6 | -7 | -5 | -8 | -4 | -9 | -3 | -10 | -2 | -11 | -1 | -12 | 0 | -13 | 1
0.00001 -5 | 2 | -12 | 1 | -11 | 0 | -10 | -1 | -9 | -2 | -8 | -3 | -7 | -4 | -6 | -5 | -5 | -6 | -4 | -7 | -3 | -8 | -2 | -9 | -1 | -10 | 0 | -11 | 1 | -12 | 2
0.0001 -4 | 3 | -11 | 2 | -10 | 1 | -9 | 0 | -8 | -1 | -7 | -2 | -6 | -3 | -5 | -4 | -4 | -5 | -3 | -6 | -2 | -7 | -1 | -8 | 0 | -9 | 1 | -10 | 2 | -11 | 3
0.001 -3 | 4 | -10 | 3 | -9 | 2 | -8 | 1 | -7 | 0 | -6 | -1 | -5 | -2 | -4 | -3 | -3 | -4 | -2 | -5 | -1 | -6 | 0 | -7 | 1 | -8 | 2 | -9 | 3 | -10 | 4
0.01 -2 | 5 | -9 | 4 | -8 | 3 | -7 | 2 | -6 | 1 | -5 | 0 | -4 | -1 | -3 | -2 | -2 | -3 | -1 | -4 | 0 | -5 | 1 | -6 | 2 | -7 | 3 | -8 | 4 | -9 | 5
0.1 -1 | 6 | -8 | 5 | -7 | 4 | -6 | 3 | -5 | 2 | -4 | 1 | -3 | 0 | -2 | -1 | -1 | -2 | 0 | -3 | 1 | -4 | 2 | -5 | 3 | -6 | 4 | -7 | 5 | -8 | 6
1 0 | 7 | -7 | 6 | -6 | 5 | -5 | 4 | -4 | 3 | -3 | 2 | -2 | 1 | -1 | 0 | 0 | -1 | 1 | -2 | 2 | -3 | 3 | -4 | 4 | -5 | 5 | -6 | 6 | -7 | 7
10 1 | 8 | -6 | 7 | -5 | 6 | -4 | 5 | -3 | 4 | -2 | 3 | -1 | 2 | 0 | 1 | 1 | 0 | 2 | -1 | 3 | -2 | 4 | -3 | 5 | -4 | 6 | -5 | 7 | -6 | 8
100 2 | 9 | -5 | 8 | -4 | 7 | -3 | 6 | -2 | 5 | -1 | 4 | 0 | 3 | 1 | 2 | 2 | 1 | 3 | 0 | 4 | -1 | 5 | -2 | 6 | -3 | 7 | -4 | 8 | -5 | 9
1000 3 | 10 | -4 | 9 | -3 | 8 | -2 | 7 | -1 | 6 | 0 | 5 | 1 | 4 | 2 | 3 | 3 | 2 | 4 | 1 | 5 | 0 | 6 | -1 | 7 | -2 | 8 | -3 | 9 | -4 | 10
10000 4 | 11 | -3 | 10 | -2 | 9 | -1 | 8 | 0 | 7 | 1 | 6 | 2 | 5 | 3 | 4 | 4 | 3 | 5 | 2 | 6 | 1 | 7 | 0 | 8 | -1 | 9 | -2 | 10 | -3 | 11
100000 5 | 12 | -2 | 11 | -1 | 10 | 0 | 9 | 1 | 8 | 2 | 7 | 3 | 6 | 4 | 5 | 5 | 4 | 6 | 3 | 7 | 2 | 8 | 1 | 9 | 0 | 10 | -1 | 11 | -2 | 12
1000000 6 | 13 | -1 | 12 | 0 | 11 | 1 | 10 | 2 | 9 | 3 | 8 | 4 | 7 | 5 | 6 | 6 | 5 | 7 | 4 | 8 | 3 | 9 | 2 | 10 | 1 | 11 | 0 | 12 | -1 | 13
10000000 7 | 14 | 0 | 13 | 1 | 12 | 2 | 11 | 3 | 10 | 4 | 9 | 5 | 8 | 6 | 7 | 7 | 6 | 8 | 5 | 9 | 4 | 10 | 3 | 11 | 2 | 12 | 1 | 13 | 0 | 14

Mult Overflows
Anytime Sexp is positive number greater than 7 Within the positive exp1, positive exp2 quadrant

OP1

OP2

(DPOvrfl=1)(SignYexp=SignXexp=0)

Div Underflows | Mult Underflows

(DPOvrfl=1)(SignYexp=SignXexp=1) (DPOvrfl=1)(SignYexp=1)(SignXexp=0)

Division Overflows
Anytime Dexp is positive number greater than 7 Within the positive exp1, negative exp2 quadrant

(DPOvrfl=1)(SignYexp=0)(SignXexp=1)

# Multiplication and Division Overflows and Underflows

### Dexp and Sexp Counter Values From All Combinations of Op1 and Op2
