Sphaeralcea/TTL_Calculator_4_Banger/BCD_Arithmetic.pdf

# BCD Arithmetic

# Assuming a 4-bit adder primitive

e.g. 7483, 74283, etc.

# BCD Addition

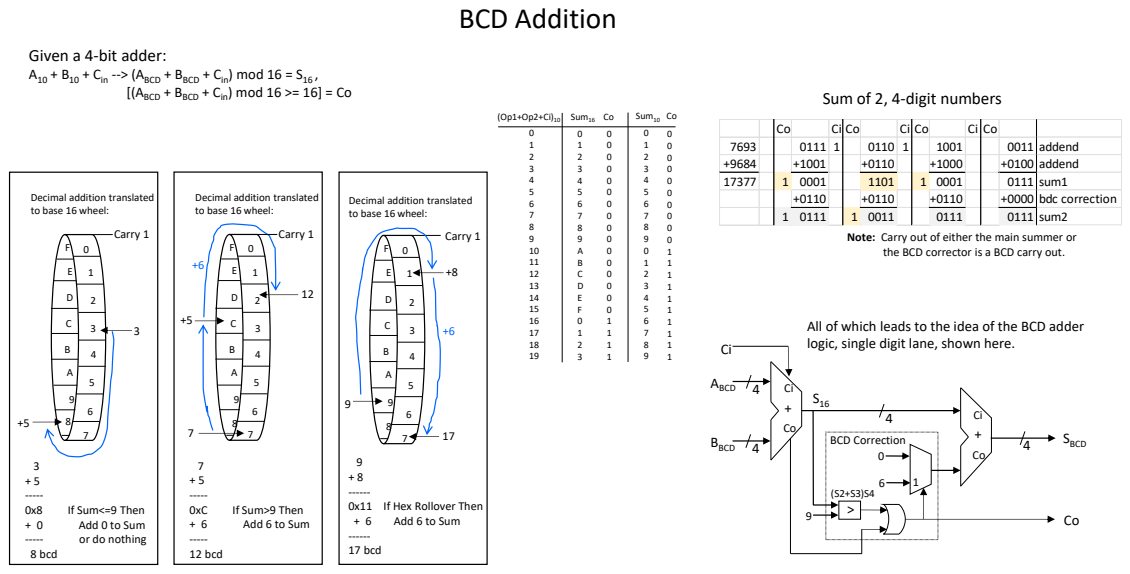
[picture p33: page 2]
bdc correction; sum2; If Sum>9 Then; Add 6 to Sum; ----- 12 bcd; Carry 1; 9 + 8 ------ 0x11 If Hex Rollover Then; ------ 17 bcd; If Sum<=9 Then; Add 0 to Sum; or do nothing; 8 bcd; Sum16; Sum10 Co; SBCD; ABCD; BBCD; BCD Correction

Given a 4-bit adder:
A10 + B10 + Cin --> (ABCD + BBCD + Cin) mod 16 = S16 ,

[(ABCD + BBCD + Cin) mod 16 >= 16] = Co

Sum of 2, 4-digit numbers

7693 | | 0111 | 1 | | 0110 | 1 | | 1001 | | | 0011 | addend
+9684 | | +1001 | | | +0110 | | | +1000 | | | +0100 | addend
17377 | 1 0001 | | | 1101 | | | 1 0001 | | | | 0111 | sum1

Decimal addition translated
to base 16 wheel:

Note: Carry out of either the main summer or
the BCD corrector is a BCD carry out.

All of which leads to the idea of the BCD adder
logic, single digit lane, shown here.

# Number Complements

# Radix complements and their sidekicks, diminished radix complements

are a numeric tool allowing subtraction be performed by addition.

- A number N, in radix R has complement numbers.
- In particular a number N in radix R has its R’s complement and its diminished R’s complement, or (R-1)’s complement.
- The R’s complement is the (R-1)’s complement plus 1.
- The (R-1)’s complement is computed by taking each digit of N and subtracting it from R-1. EX: If R=2 and N=1110, the 1’s complement is 0001,
and the 2’s complement is 0001 plus 1 or 0010.

999
-752
247

To take the 9’s complement of a number, say 752,
subtract each digit of the
number from 9.

To subtract two numbers using 9’s complement arithmetic:
- Add the 9’s complement of the subtrahend to the minuend.
- If there is a carry out of the most significant digit, then add 1 to the result. The result is positive.
- If there is no carry out of the most significant digit, the result is negative and must be 9’s complemented.

5841 – 2963 = 2878

9999
- 2963
7036
+5841
1 | 2877
1
2878

4691 – 6849 = - 2158

9999
- 6849
3150
+4691
0 | 7841

9999
-7841
- 2158

999
-750
249
+ 1
250

To take the 10’s complement of a number, say 750,
subtract each digit of the
number from 9 and add 1 to
the result.

To subtract two numbers using 10’s compl. arithmetic:
- Add the 10’s complement of the subtrahend to the minuend.
- If there is a carry out of the most significant digit, the result is positive.
- If there is no carry out of the most significant digit, the result is negative and must be 10’s complemented.

5841 – 2963 = 2878

9999
- 2963
7036
+ 1
| 7037
+5841
1 | 2878

4691 – 6849 = - 2158

9999
- 6849
3150
+ 1
| 3151
+ 4691
0 | 7842

# 9’s and 10’s Complement Subtraction

9999
-7842
2157
+ 1
- 2157

9’s complement of subtrahend

Add the minuend

Add MSD carry to sum

Difference is positive

9’s complement of subtrahend

Add the minuend

Difference is negative

9’s complement of difference

10’s complement of subtrahend

Add the minuend

Difference is positive

10’s complement of subtrahend

Difference is negative

10’s comp of diff

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
Co=1
Result pos

7 - 2
(7 + 7) mod 10

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
Co=0
result is neg

-6

+1
+1

3 - 7
(3 + 3) mod 10

-4

# 10’s Complement Arithmetic With A 4-Bit Binary Adder

9-2 = (F-2+10)mod16 = (~2+A)mod16; F-9+10 = (~9+A)mod16; 10’s complement of 290; F-0+10 = (~0+A)mod16; 709 + 1 ------ 710 = 10’s complement of 290; 9’s complement of N; A0BCD; AnBCD; B0BCD; BnBCD

For a 4-bit binary number, or hex digit H, the F’s
complement of H is 0xF – H.

9s complement of 2 translated to
base 16 wheel: (F-2)-6 = (F-2)+A = 7

*Note that the F’s complement of a 4-bit number is
also the 1’s complement of that 4-bit number.

For a BCD digit N, the 9’s complement of N is the F’s
complement of N minus the number of hex digits
not part of the decimal digit set (A,B,C,D,E,F), which
Or more specifically,
(0xF – N – 0x6) mod 16.

And that is the same as:
(0xF – N + 0xA) mod 16
And
(*1’scomp(N) + 0xA) mod 16
Which is

The 10’s complement of a number N is still just the
9’s complement plus 1.

This suggests the idea of a BCD subtractor looks in
part looks like the diagram on the right.

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
Op1-Op2 Co A + 10#(B) SUM
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
# BCD Subtraction

Co | Ci | Co | Ci
A | 47 | 0100 | 0111 | minuend
B | -28 | -0010 | -1000 | subtrahend
19
1101 | 0111 | 1's complement of subtrahend
+1010 | +1010 | 1 | add 10 (and 1 more for LSD)
1 | 0111 | 1 | 0010 | 10's complement of subtrahend
+0100 | +0111 | add minuend
1011 | 1001 | difference
+0110 | +0000 | bcd correction
1 | 0001 | 1001
Final carry=1 difference is pos (A>=B)
Co | Ci | Co | Ci
A | 28 | 0010 | 1000 | minuend
B | -41 | -0100 | -0001 | subtrahend
-13
1011 | 1110 | 1's complement of subtrahend
+1010 | +1010 | 1 | add 10 (and one more)
1 | 0101 | 1 | 1001 | 10's complement of subtrahend
+0010 | 1 | +1000 | add minuend
0 | 1000 | 1 | 0001 | difference
+0000 | +0110 | bcd correction
1000 | 0111
Final carry=0 difference is neg (A<B)
0111 | | 1000 | | 1's complement
+1010 | | +1010 | 1 | add 10 (and one more)
0001 | 1 | 0011 | | 10's complement

A single digit BCD subtractor conceptually looks like this

ABCD; BBCD; Sign; BCD Correction; 1s comp; SBCD; 10’s Comp

# Example of Combinational Three-Digit BCD Adder/Subtractor

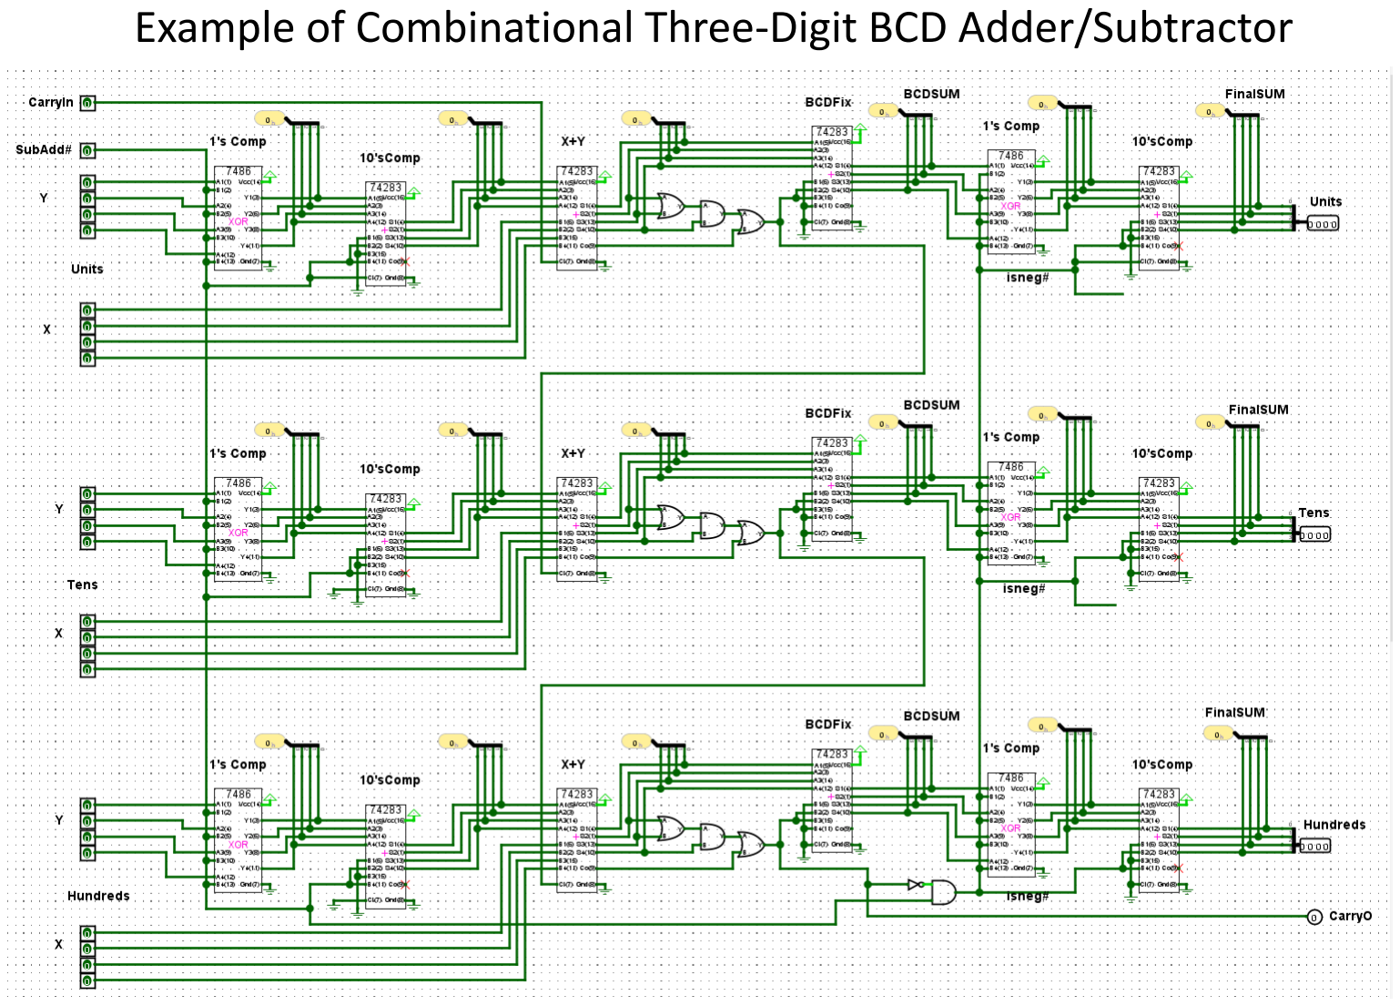
[picture p34: page 7]
