Sphaeralcea/TTL_Calculator_4_Banger/4-Bang-Pic.JPG

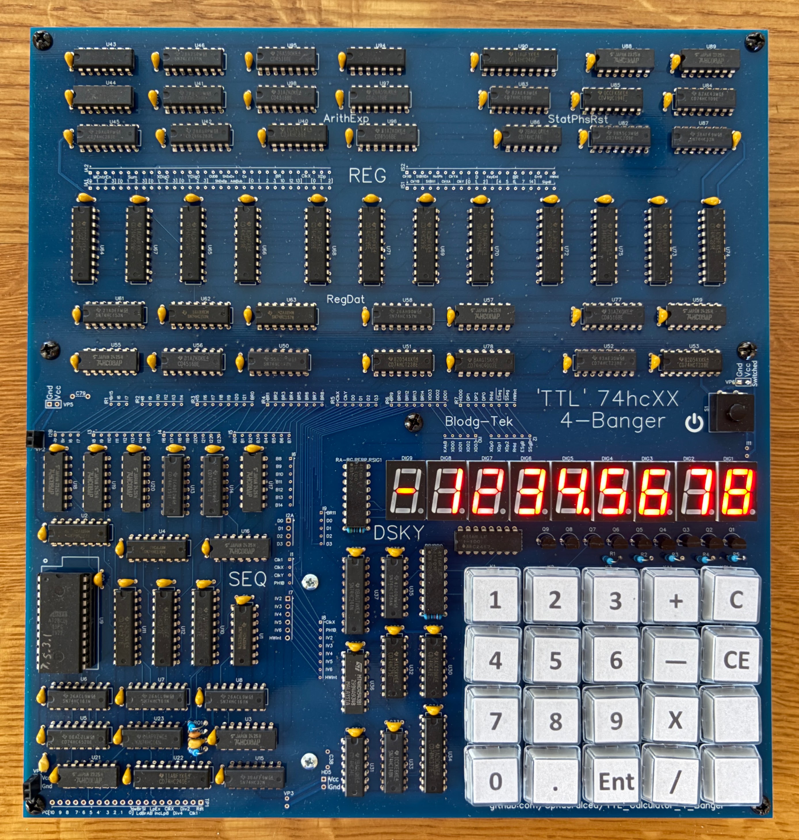
4-Bang-Pic.JPG
