Sphaeralcea/TTL_Calculator_4_Banger/Schematic_DSKY.pdf

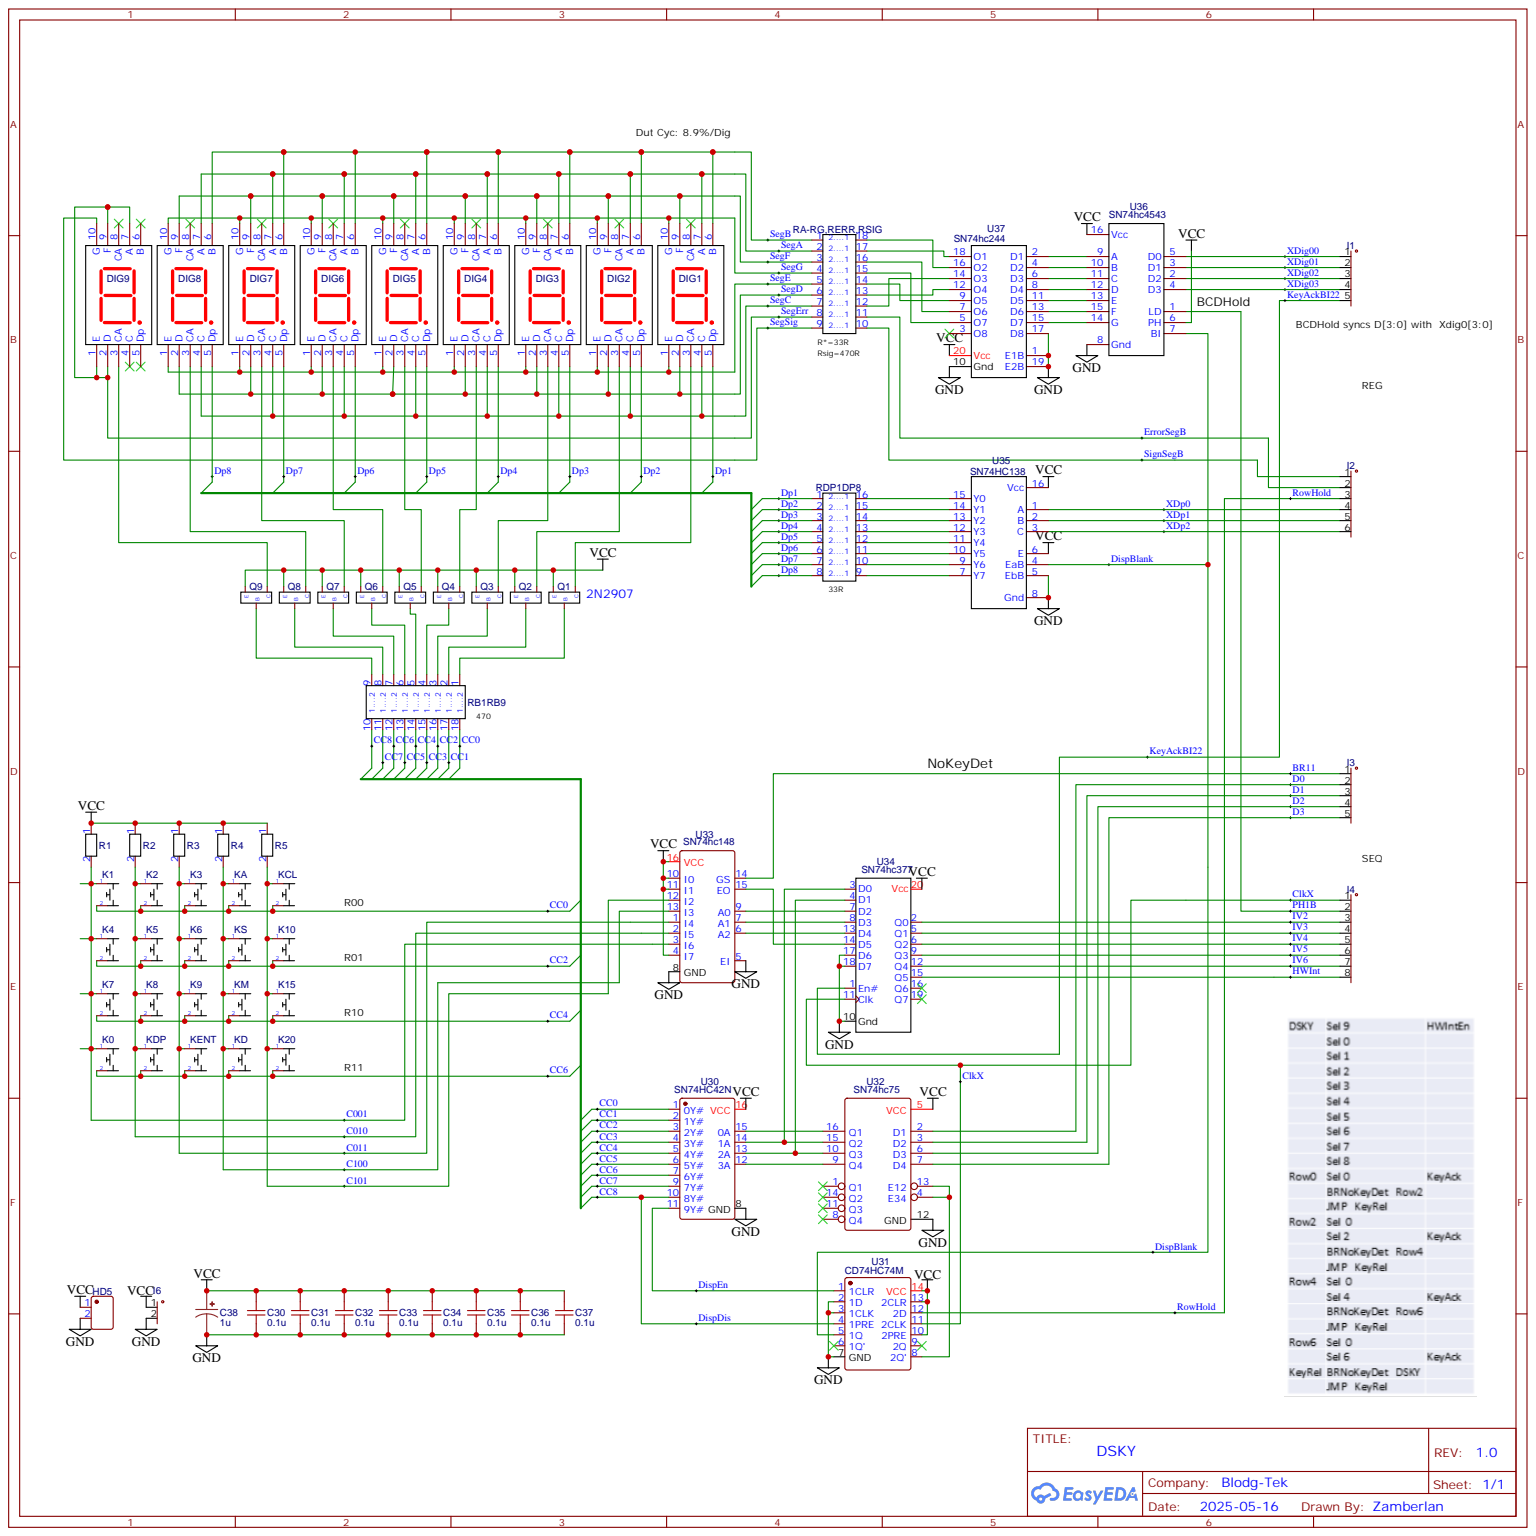
[picture p36: page 1]

RA-RG,RERR,RSIG 1
SegB
