Sphaeralcea/TTL_Calculator_4_Banger/Schematic_EERPOM2816.pdf

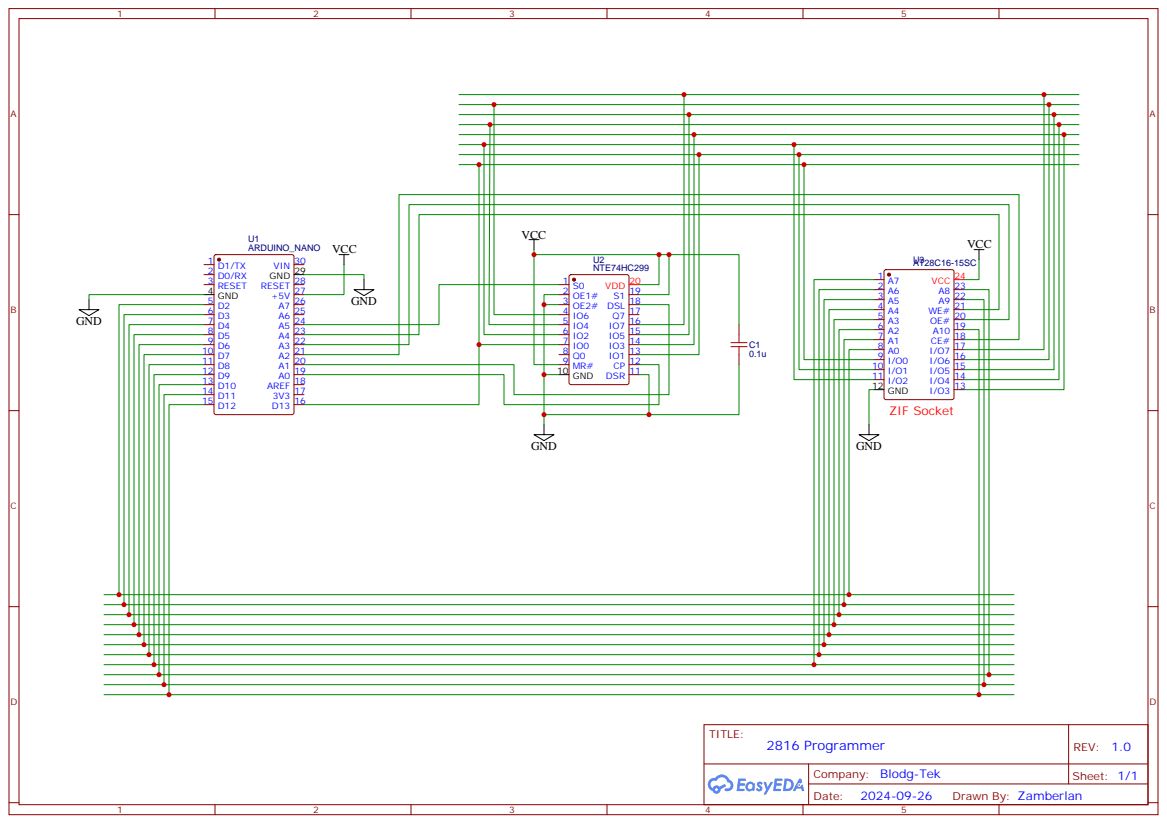
[picture p37: page 1]
