Sphaeralcea/TTL_Calculator_4_Banger/Schematic_RegsArithStat.pdf

## AddBSub

## CarryEn

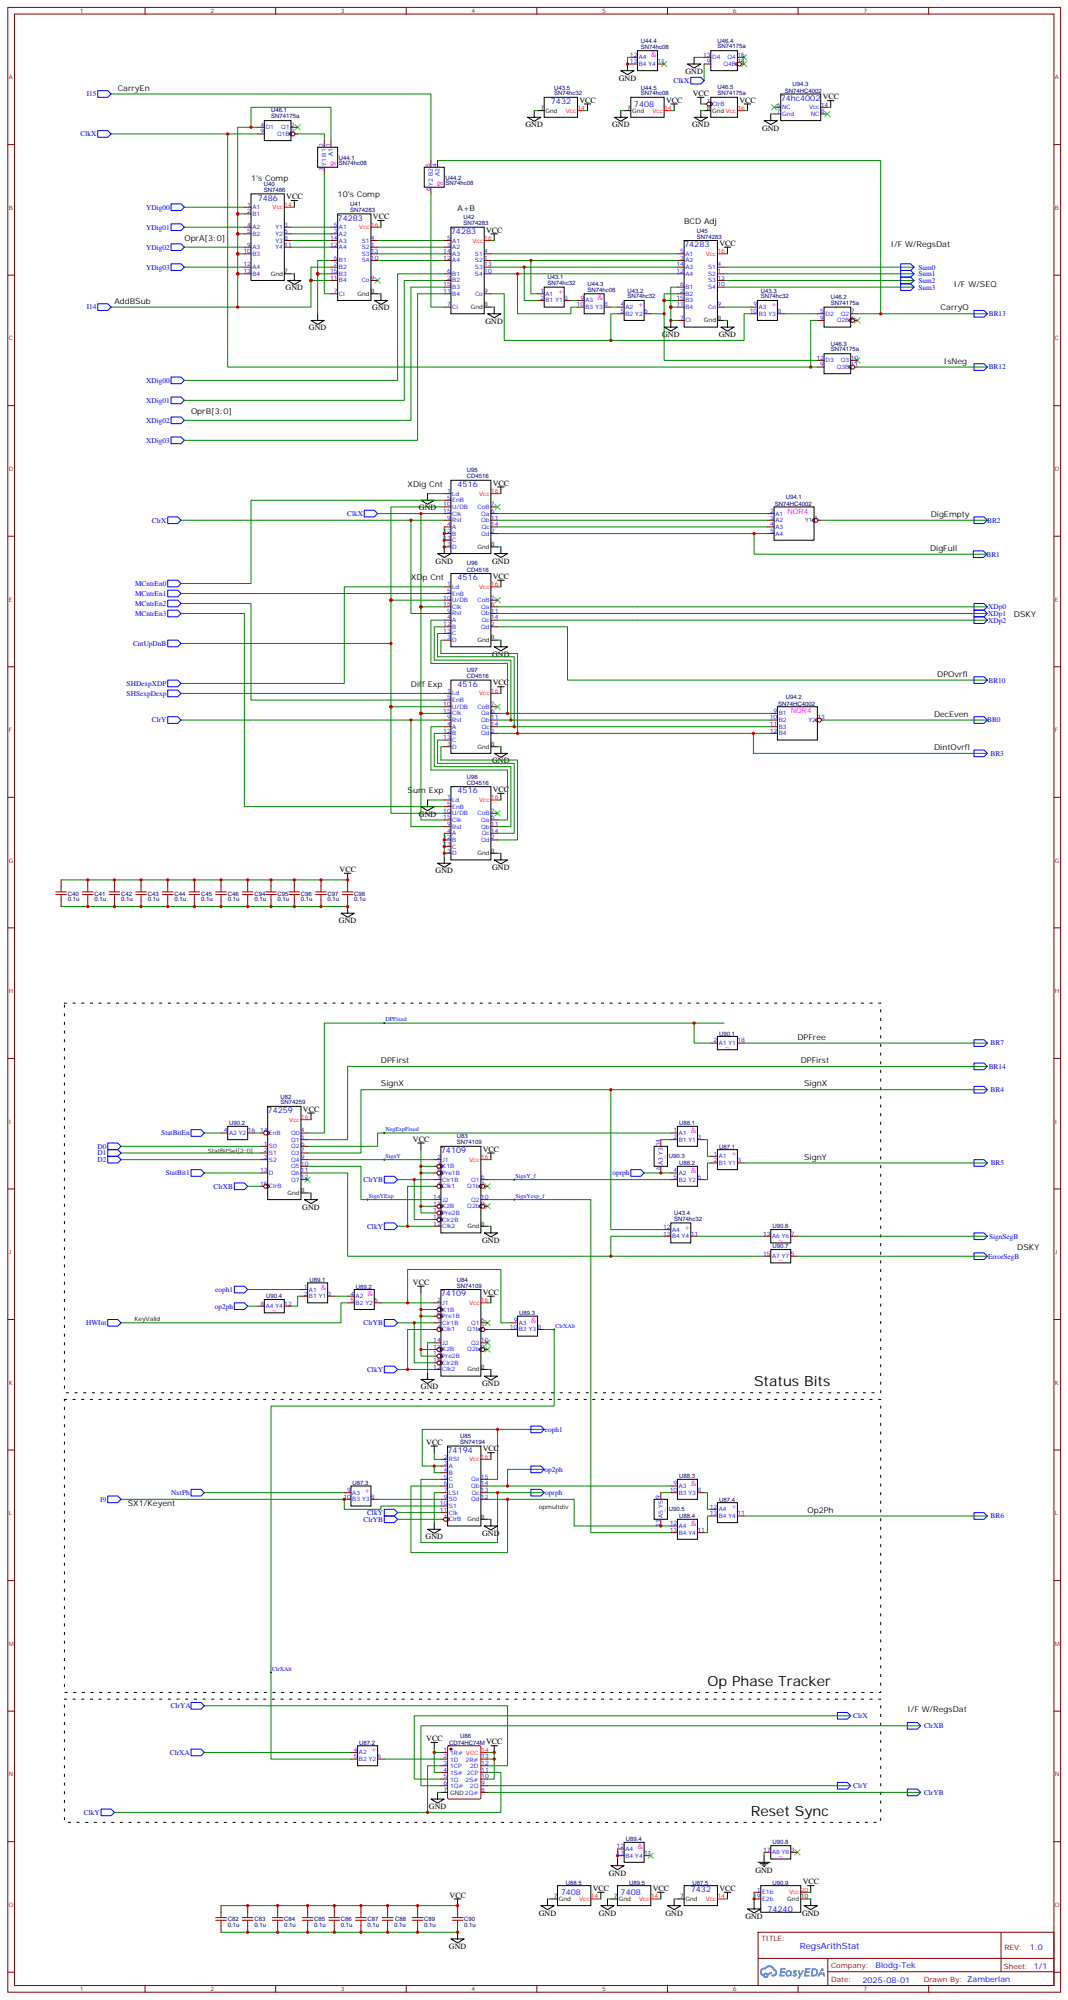
[picture p38: page 1]

## ArithExp I/F with RegsDat

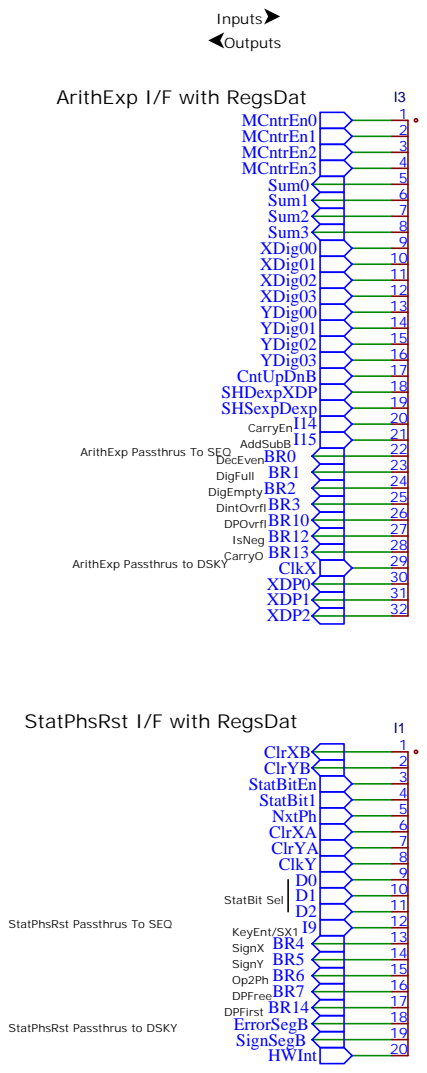
[picture p39: page 2]

ArithExp Passthrus To SEQ

ArithExp Passthrus to DSKY

StatPhsRst Passthrus To SEQ

StatPhsRst Passthrus to DSKY
