Sphaeralcea/TTL_Calculator_4_Banger/Schematic_RegsDat.pdf

74153

74153

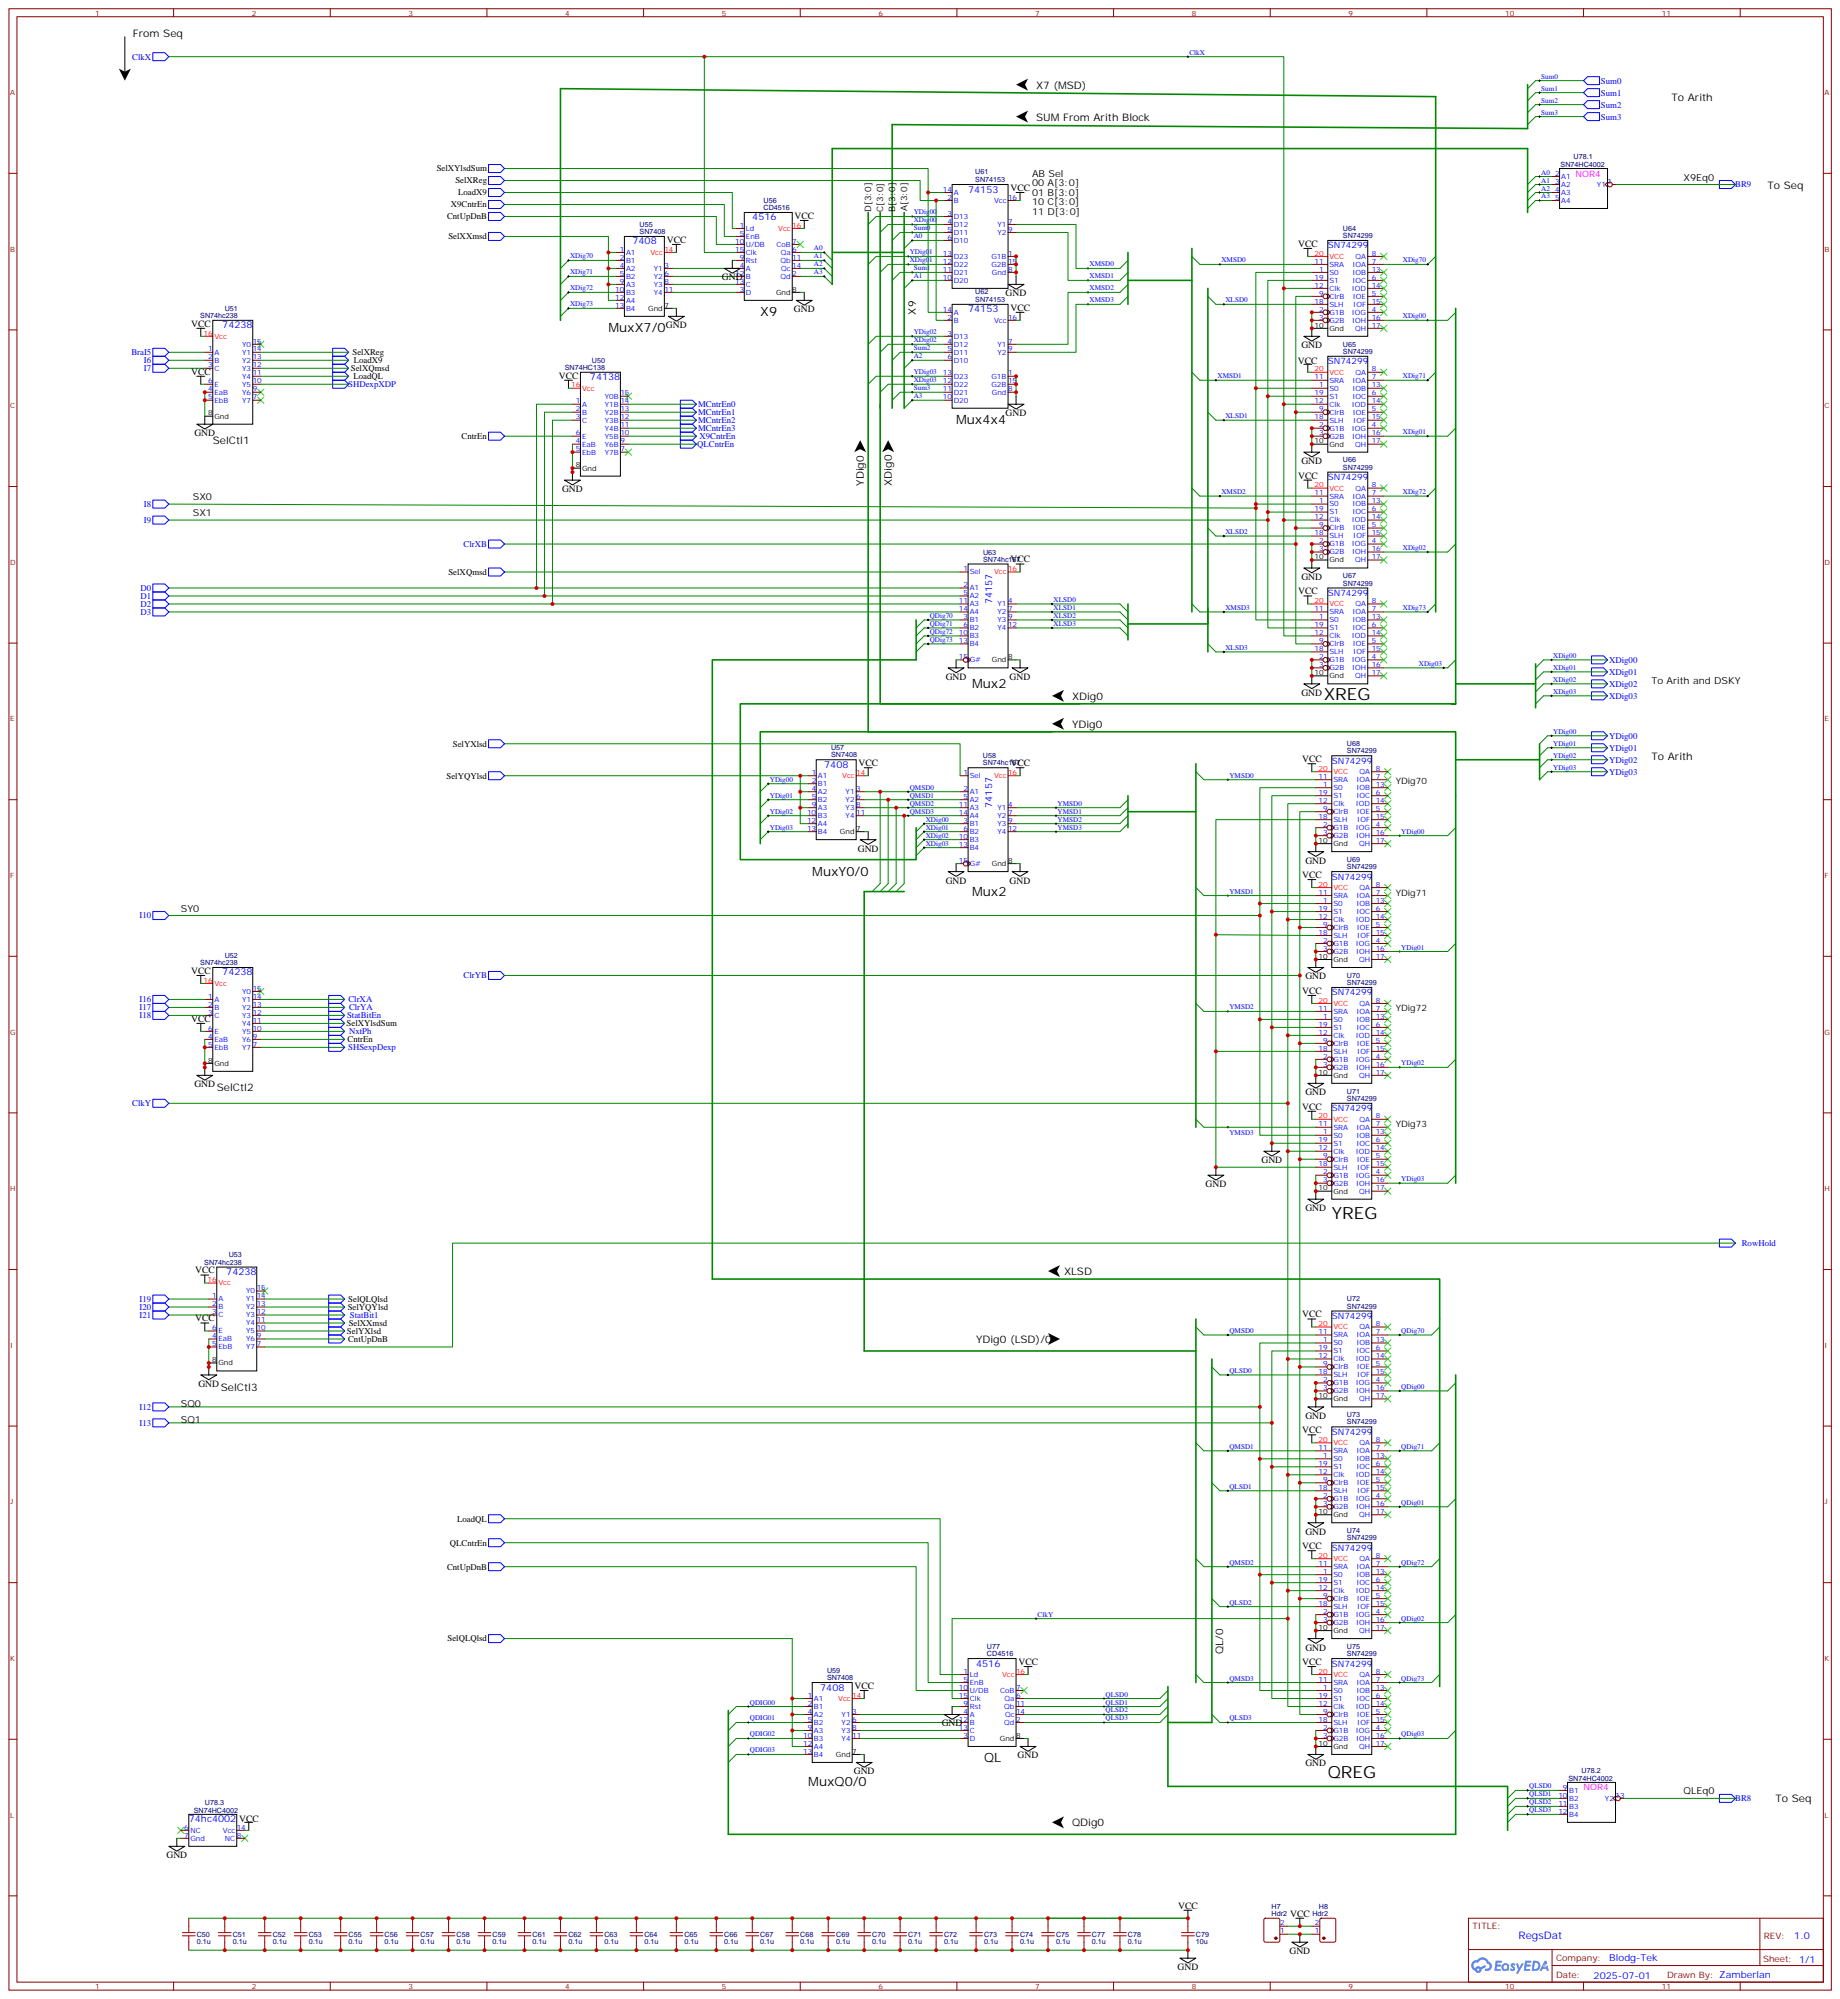
[picture p40: page 1]

SUM From Arith Block

To Arith and DSKY

## SEQ I/F With RegsDat

REG I/F With SEQ/DSKY | RegsData I/F With ArithExp

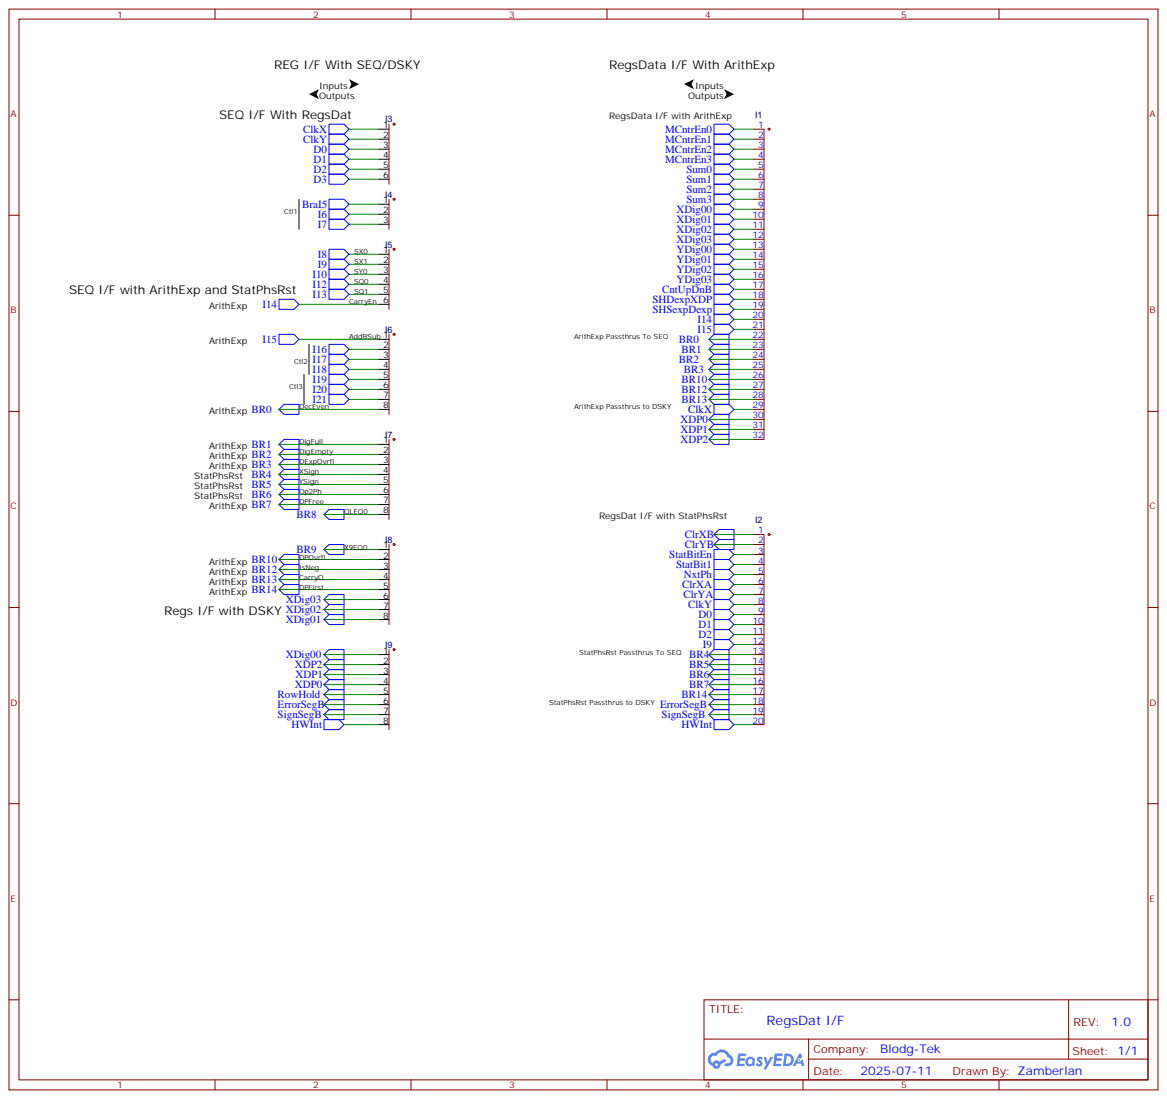
[picture p41: page 2]

SEQ I/F with ArithExp and StatPhsRst

ArithExp Passthrus To SEQ

ArithExp Passthrus to DSKY

StatPhsRst Passthrus To SEQ

StatPhsRst Passthrus to DSKY
