Sphaeralcea/TTL_Calculator_4_Banger/Schematic_SEQ.pdf

# 2E 10 2Q0 11 2Q1 12 2Q2 13 2Q3 14 2MR 15 VCC 16

&

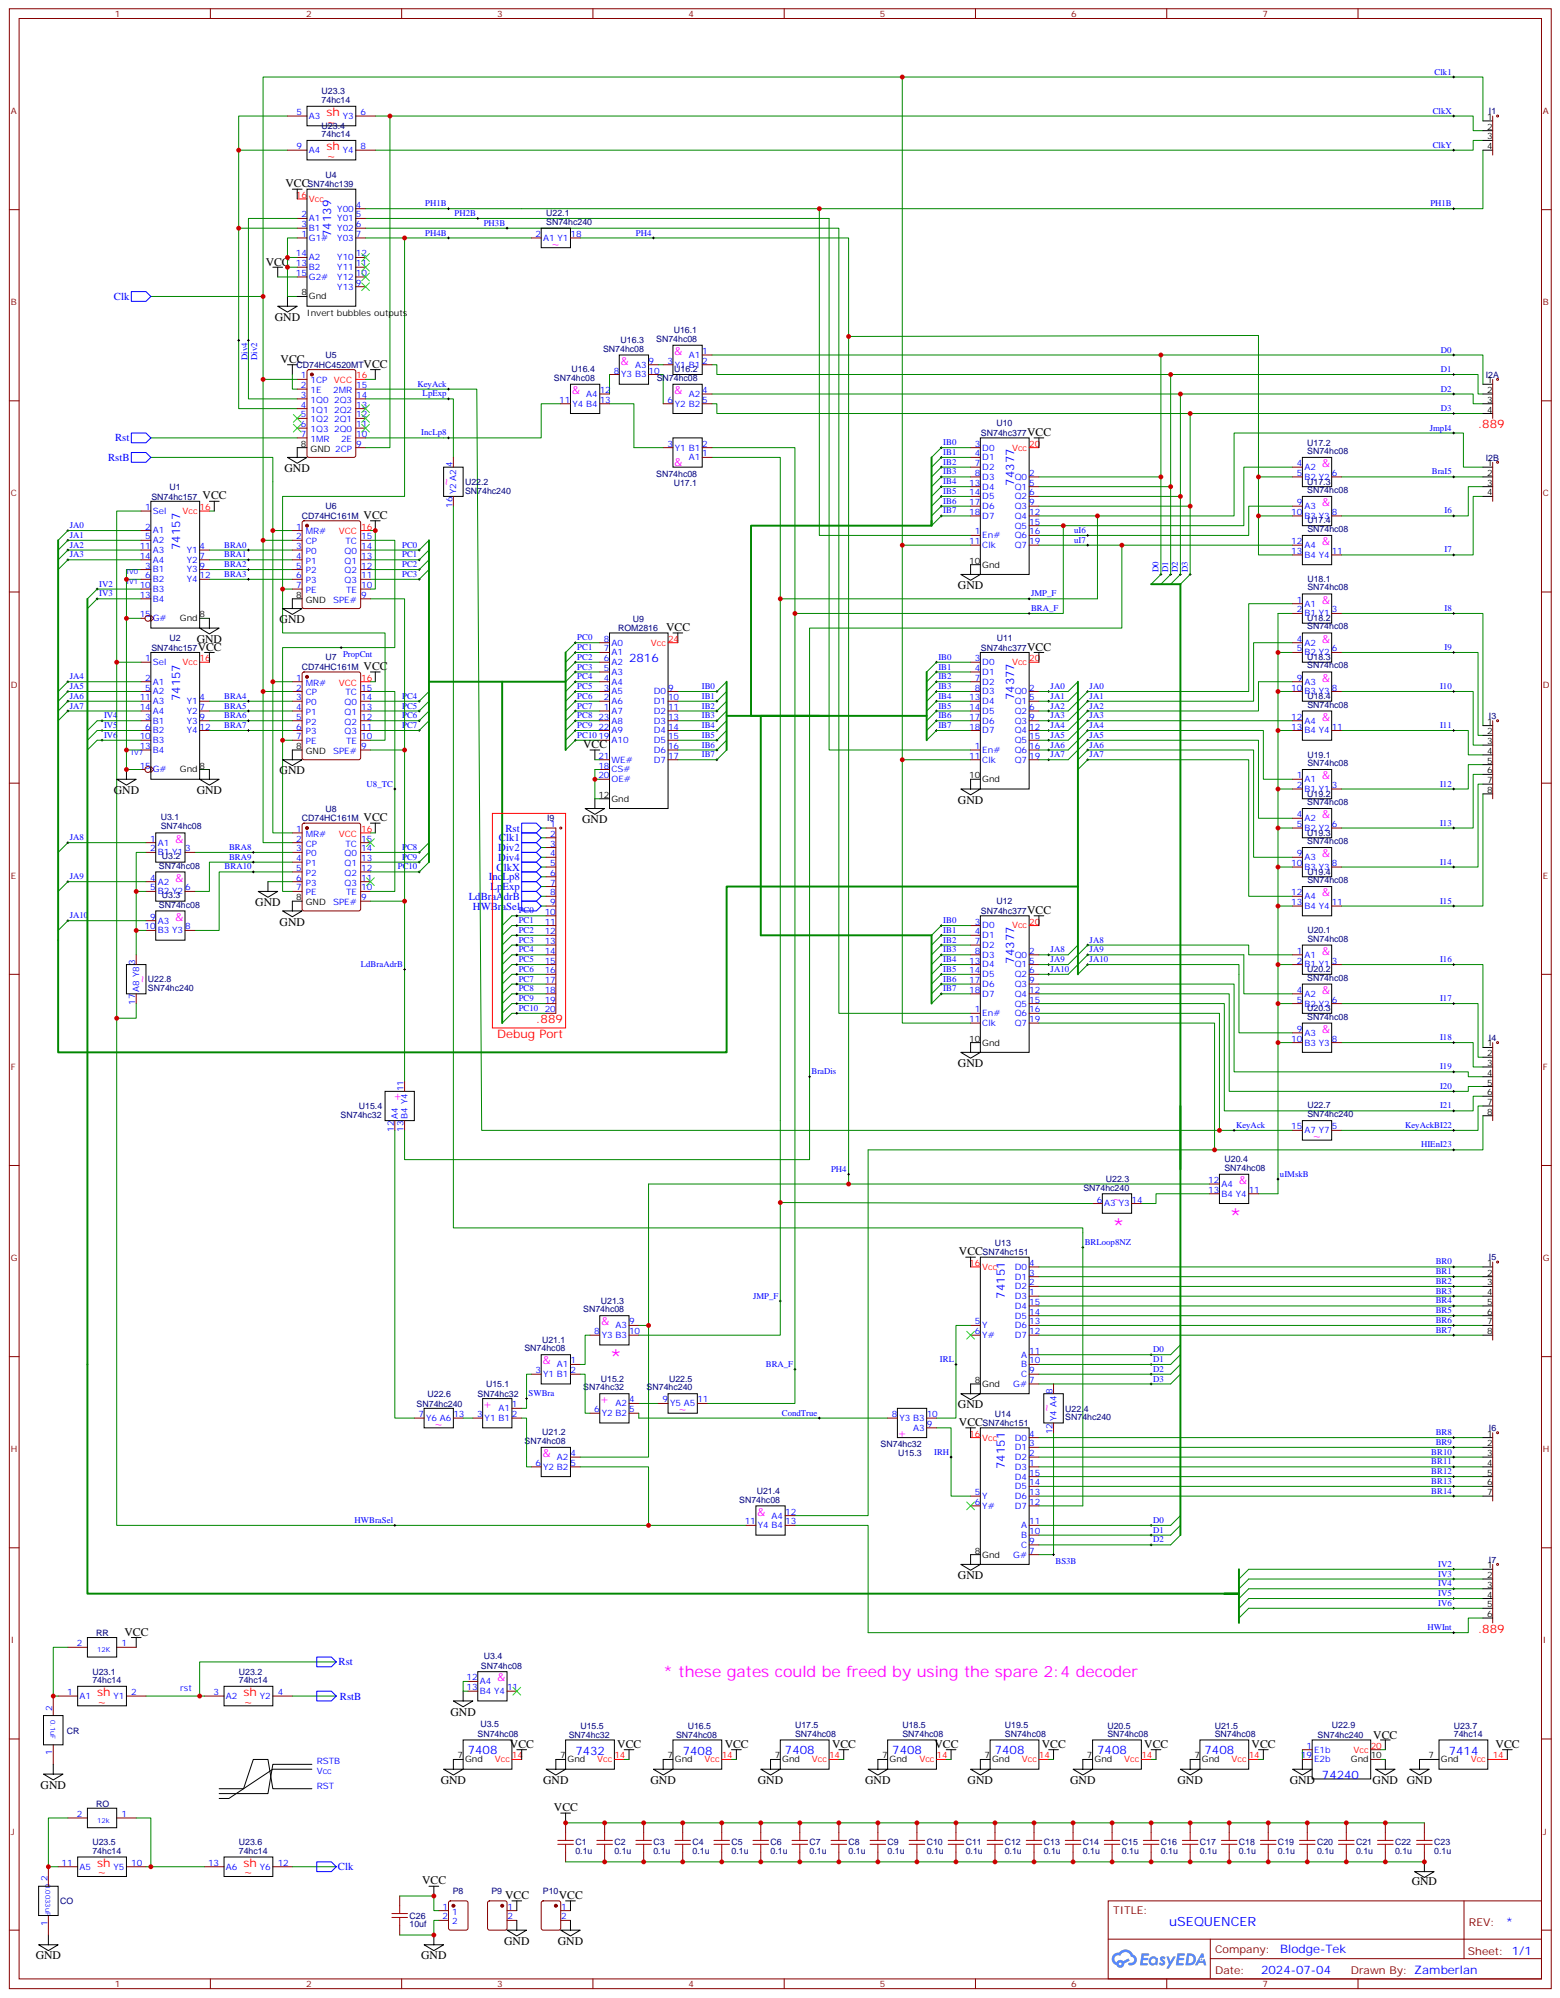
[picture p42: page 1]

* these gates could be freed by using the spare 2:4 decoder
