Sphaeralcea/TTL_Calculator_4_Banger/uROM.h

// 7.5.3.2
#define ROMSZ  2025

const byte ROM[ROMSZ] PROGMEM= {
0x00,	0x00,	0x00,	
0x00,	0x00,	0x00,	
0x10,	0x2B,	0x02,	
0x00,	0x00,	0x00,	
0x00,	0x00,	0x00,	0x00,
0x10,	0x7D,	0x41,	0x00,
0x10,	0x8F,	0x41,	0x00,
0x10,	0xA1,	0x41,	0x00,
0x10,	0x1D,	0x41,	0x00,
0x10,	0x83,	0x41,	0x00,
0x10,	0x95,	0x41,	0x00,
0x10,	0xA7,	0x41,	0x00,
0x10,	0x01,	0x42,	0x00,
0x10,	0x89,	0x41,	0x00,
0x10,	0x9B,	0x41,	0x00,
0x10,	0xAD,	0x41,	0x00,
0x10,	0xA3,	0x42,	0x00,
0x10,	0x33,	0x43,	0x00,
0x10,	0x12,	0x43,	0x00,
0x10,	0x98,	0x44,	0x00,
0x10,	0xA6,	0x45,	0x00,
0x10,	0x2B,	0x42,	0x00,
0x10,	0x3D,	0x42,	0x00,
0x10,	0x2B,	0x42,	0x00,
0x10,	0x2B,	0x42,	0x00,
0x09,	0x00,	0x80,	
0x00,	0x00,	0x00,	
0x00,	0x00,	0x00,	
0x00,	0x00,	0x00,	
0x00,	0x00,	0x00,	
0x20,	0x01,	0x00,	
0x01,	0x00,	0x00,	
0x01,	0x00,	0x00,	
0x01,	0x00,	0x00,	
0x01,	0x00,	0x00,	
0x21,	0x01,	0x00,	
0x02,	0x00,	0x00,	
0x02,	0x00,	0x00,	
0x02,	0x00,	0x00,	
0x02,	0x00,	0x00,	
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

};			
