Sphaeralcea/TTL_Calculator_4_Banger/(commit log)

2026-05-17 Correct ZIP file extension case in README
2026-08-07 Update README to remove PowerPoint overview reference
    Removed reference to PowerPoint overview from contents.
